lsartory/LitterRobot/PCB/LitterRobot.pdf

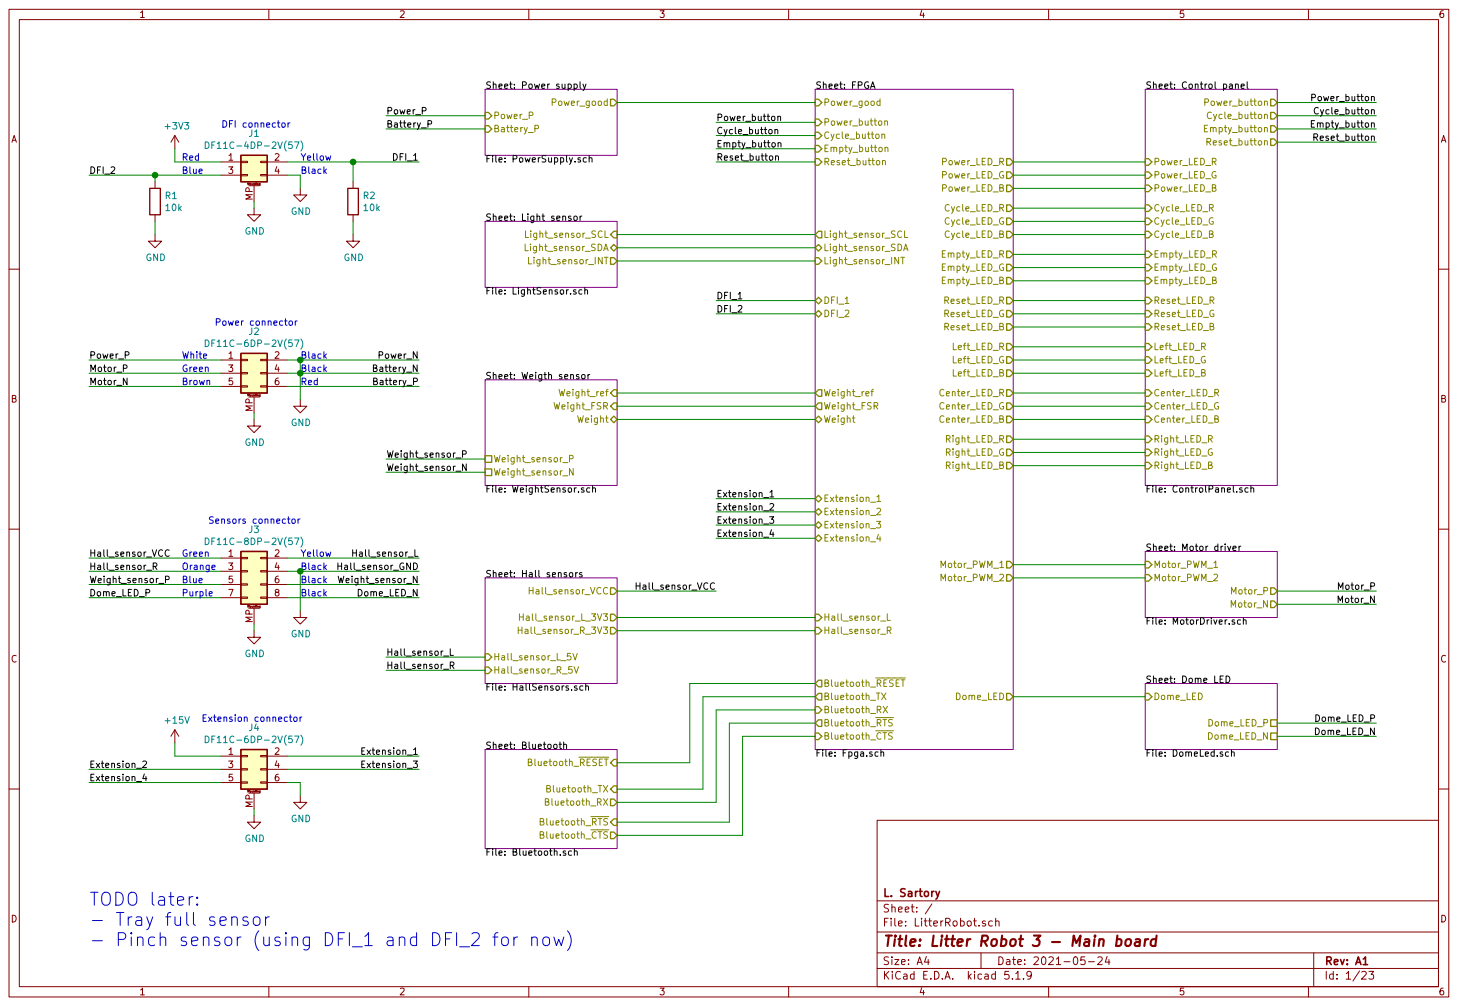
[picture p1: page 1]

Sheet: Control panel File: ControlPanel.sch Power_button Cycle_button

Sheet: Hall sensors File: HallSensors.sch Hall_sensor_VCC

Bluetooth_RESET Sheet: Bluetooth File: Bluetooth.schBluetooth_TX

- Pinch sensor (using DFI_1 and DFI_2 for now) Extension connector

File: LitterRobot.sch Sheet: / L. Sartory

Id: 1/23 Title: Litter Robot 3 - Main board

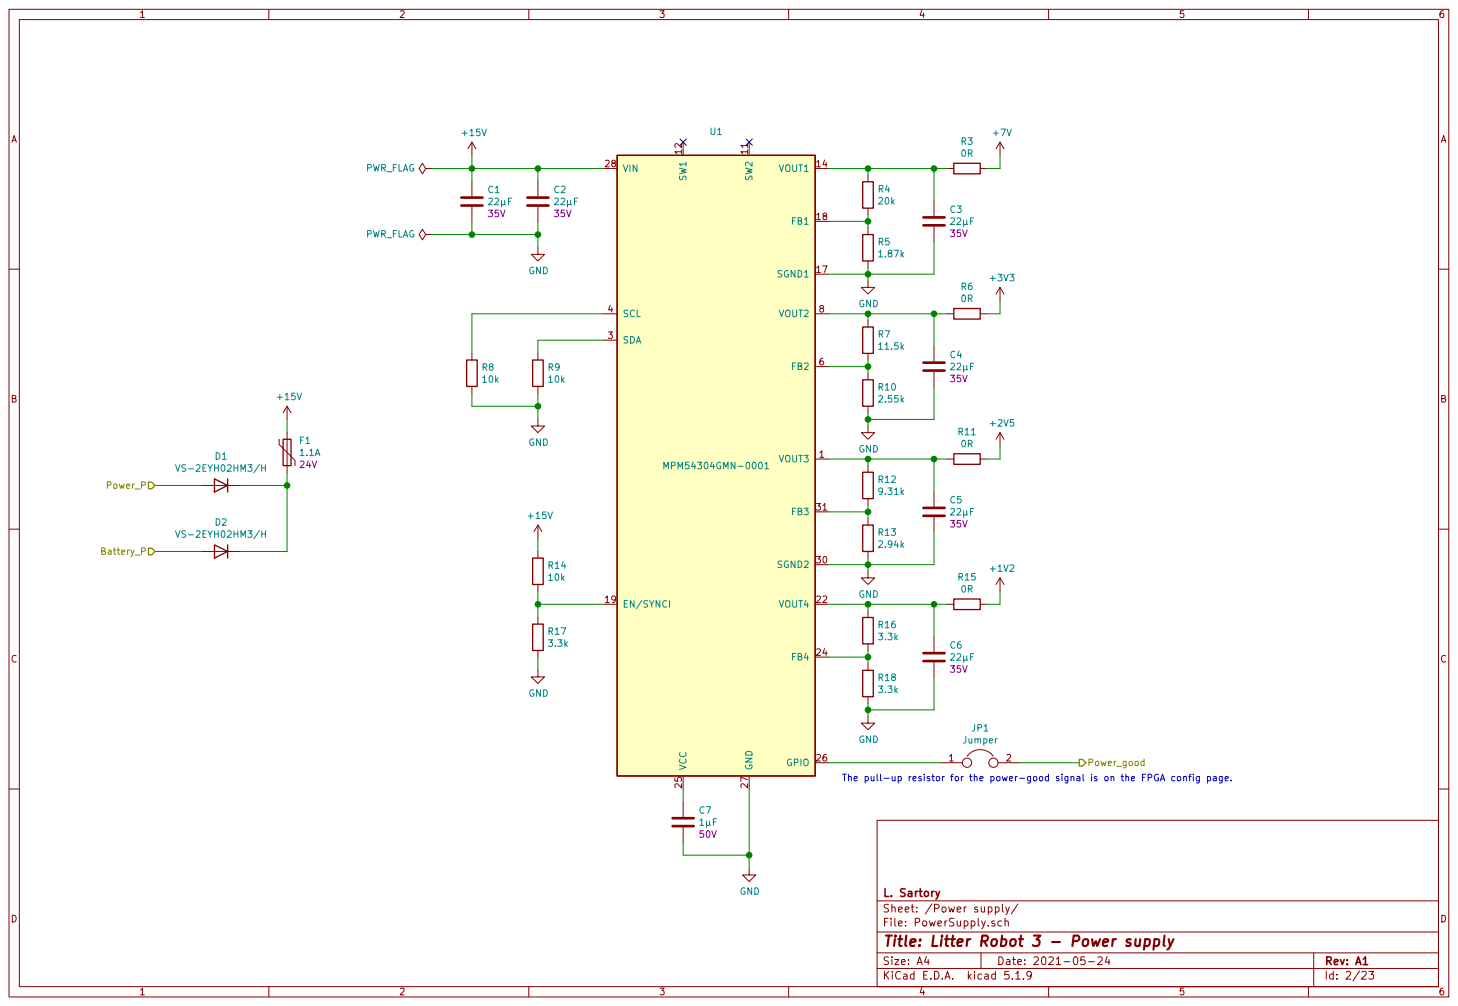
[picture p2: page 2]

The pull-up resistor for the power-good signal is on the FPGA config page.

Sheet: /Power supply/
File: PowerSupply.sch
Id: 2/23 Title: Litter Robot 3 - Power supply

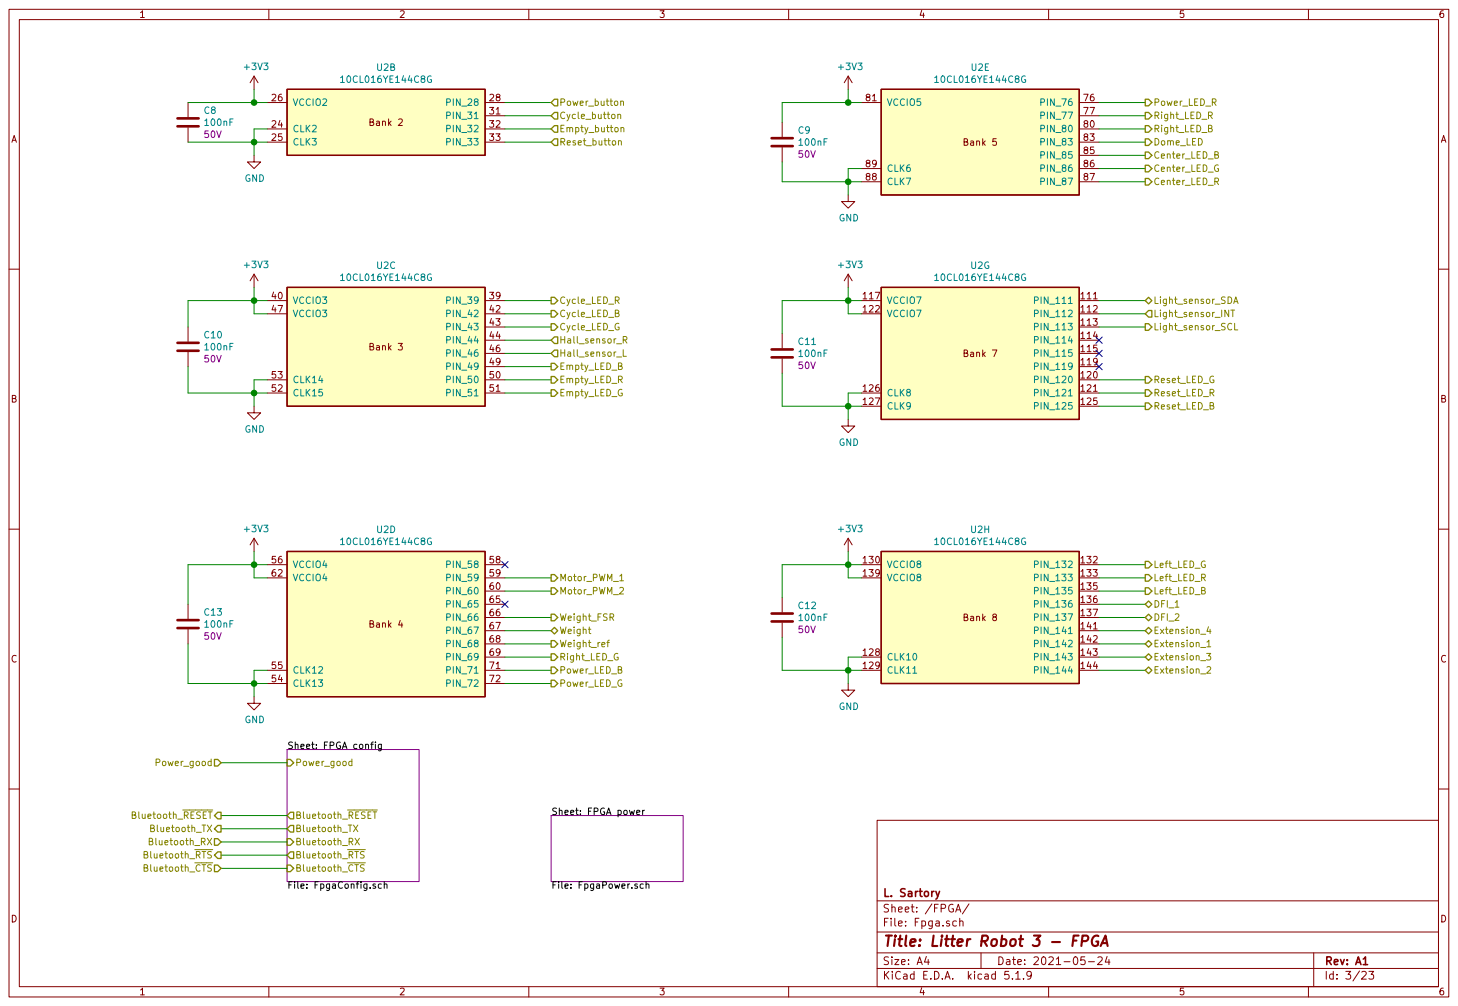
[picture p3: page 3]

File: Fpga.sch Sheet: /FPGA/ L. Sartory

Id: 3/23 Title: Litter Robot 3 - FPGA

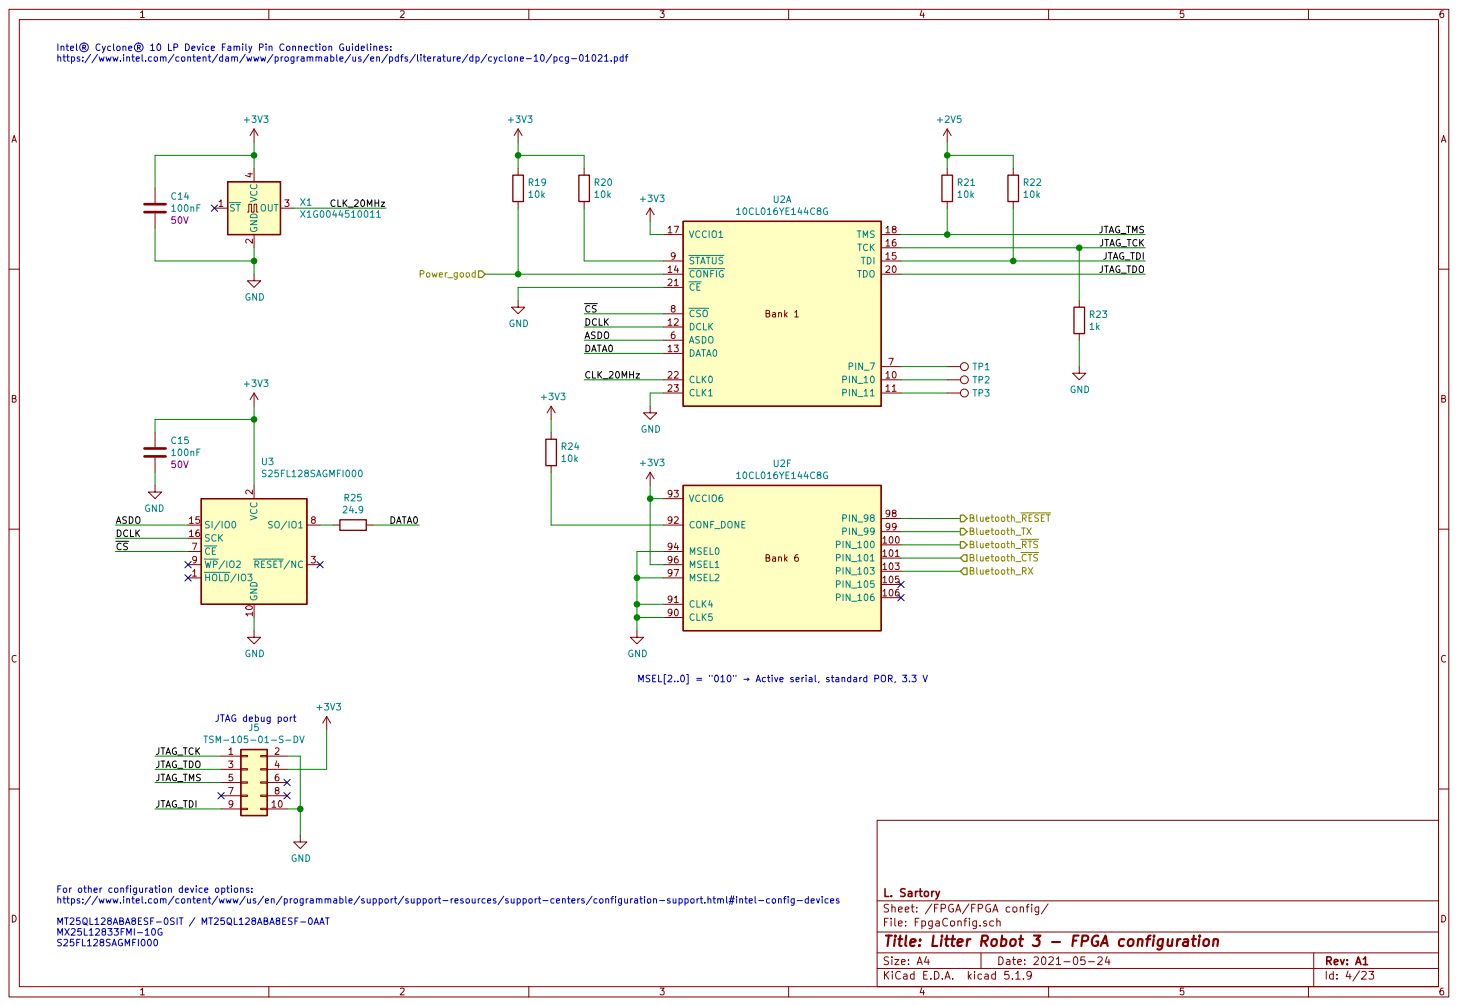
[picture p4: page 4]

Intel® Cyclone® 10 LP Device Family Pin Connection Guidelines:
https://www.intel.com/content/dam/www/programmable/us/en/pdfs/literature/dp/cyclone-10/pcg-01021.pdf

JTAG_TDI MSEL[2..0] = "010" Active serial, standard POR, 3.3 V

2 RESET/NC 3 CE 7 SO/IO1 8 WP/IO2 9 U3S25FL128SAGMFI000 GND

For other configuration device options:
https://www.intel.com/content/www/us/en/programmable/support/support-resources/support-centers/configuration-support.html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 MT25QL128ABA8ESF-0SIT / MT25QL128ABA8ESF-0AAT MX25L12833FMI-10G

L. Sartory
Sheet: /FPGA/FPGA config/
File: FpgaConfig.sch
Id: 4/23 Title: Litter Robot 3 - FPGA configuration

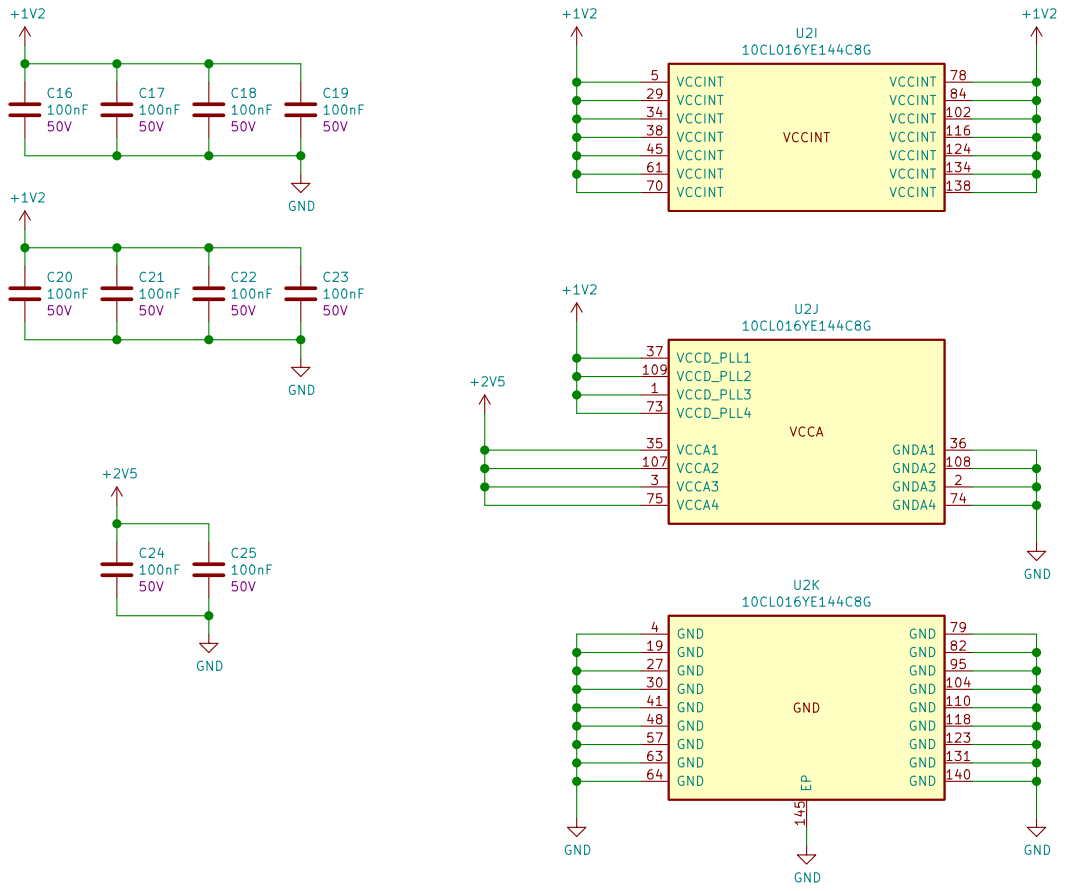
[picture p5: page 5]

L. Sartory
Sheet: /FPGA/FPGA power/
File: FpgaPower.sch
Id: 5/23 Title: Litter Robot 3 - FPGA power supply

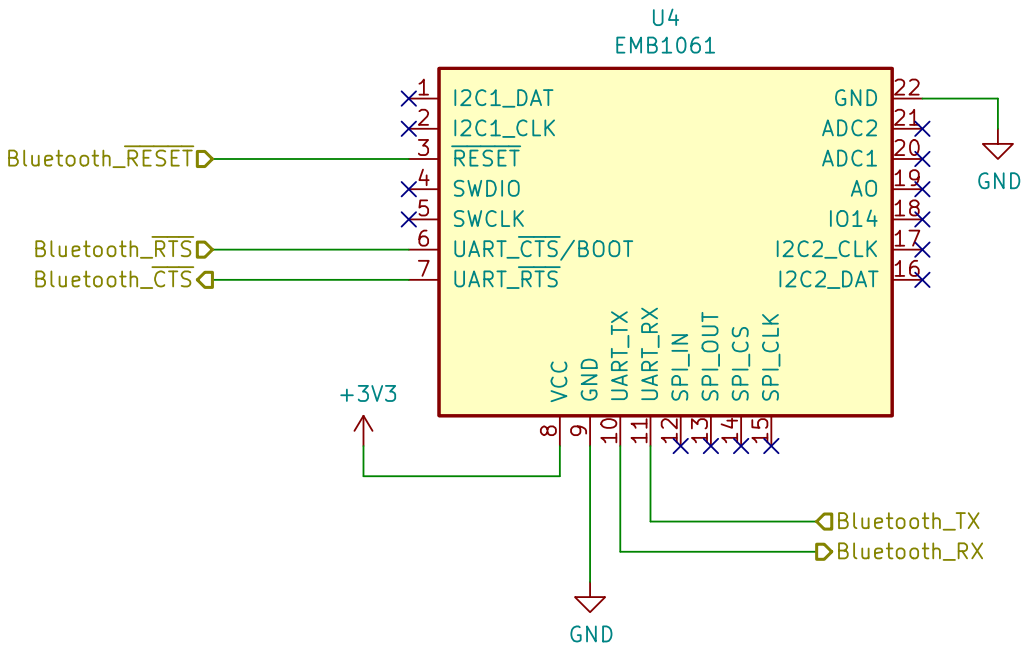
[picture p6: page 6]

File: Bluetooth.sch Sheet: /Bluetooth/ L. Sartory

Id: 6/23 Title: Litter Robot 3 - Bluetooth module

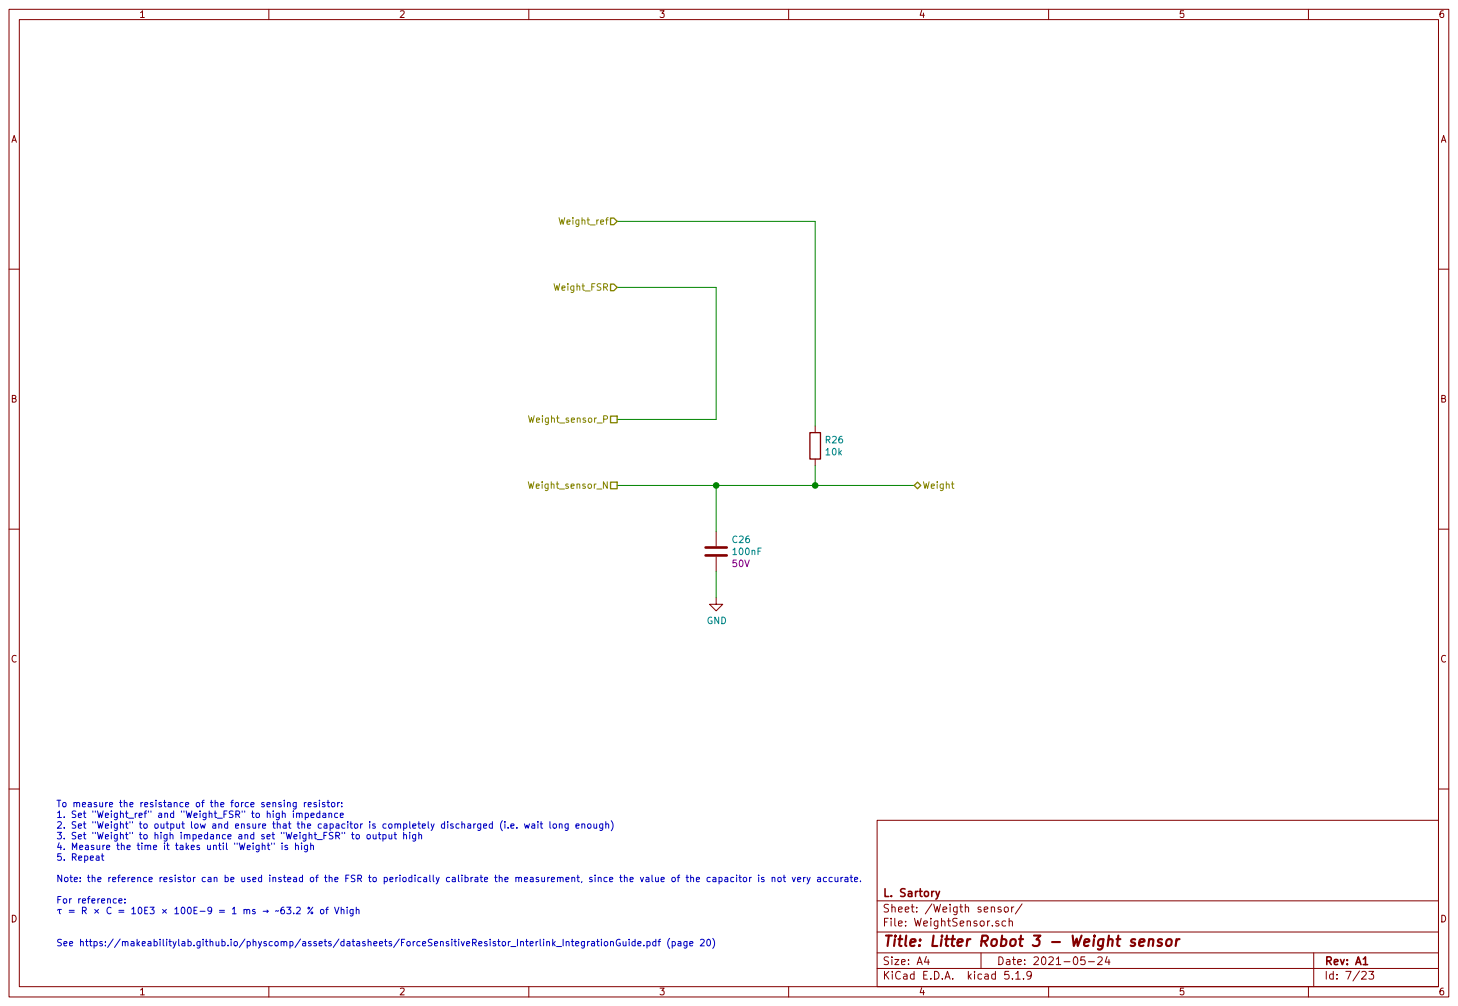
[picture p7: page 7]

To measure the resistance of the force sensing resistor:
1. Set "Weight_ref" and "Weight_FSR" to high impedance
2. Set "Weight" to output low and ensure that the capacitor is completely discharged (i.e. wait long enough)
3. Set "Weight" to high impedance and set "Weight_FSR" to output high
4. Measure the time it takes until "Weight" is high
5. Repeat

Note: the reference resistor can be used instead of the FSR to periodically calibrate the measurement, since the value of the capacitor is not very accurate. For reference:

Sheet: /Weigth sensor/
File: WeightSensor.sch
Id: 7/23 Title: Litter Robot 3 - Weight sensor

See https://makeabilitylab.github.io/physcomp/assets/datasheets/ForceSensitiveResistor_Interlink_IntegrationGuide.pdf (page 20)

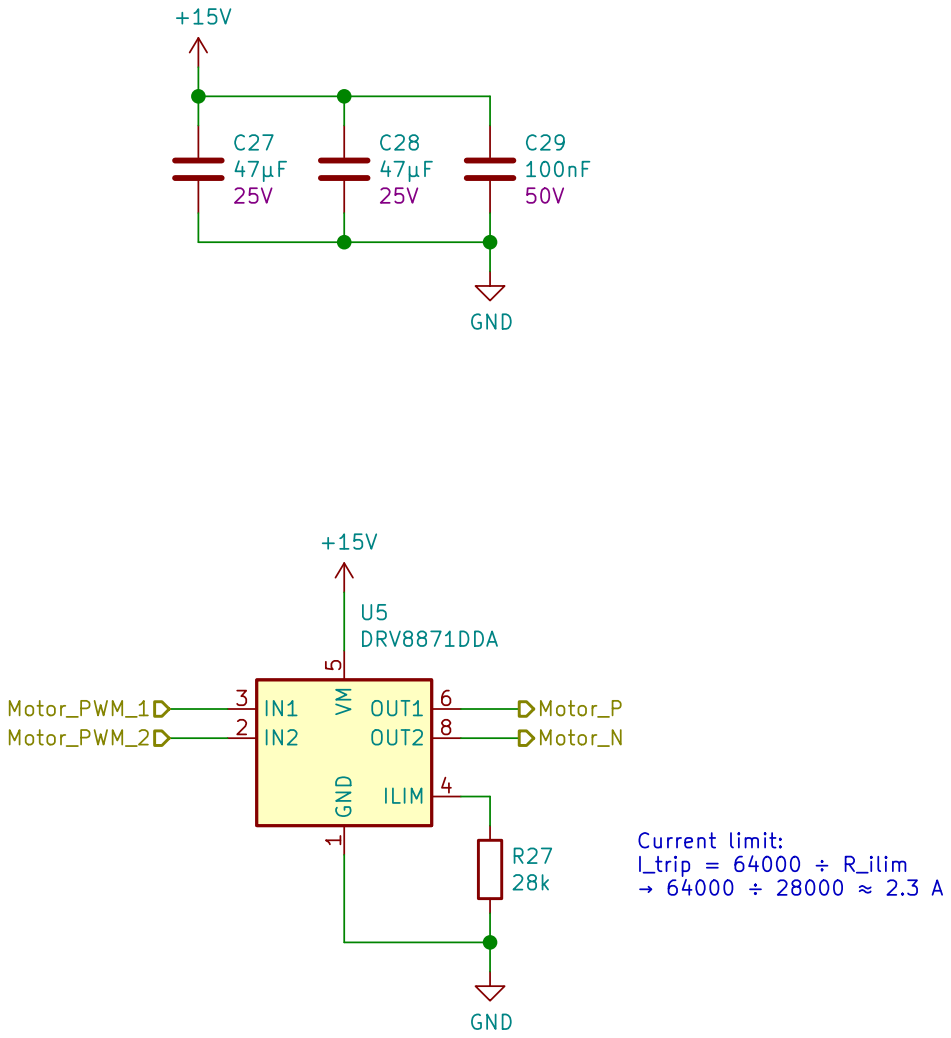
[picture p8: page 8]

Id: 8/23 Title: Litter Robot 3 - Motor driver File: MotorDriver.sch Sheet: /Motor driver/ L. Sartory

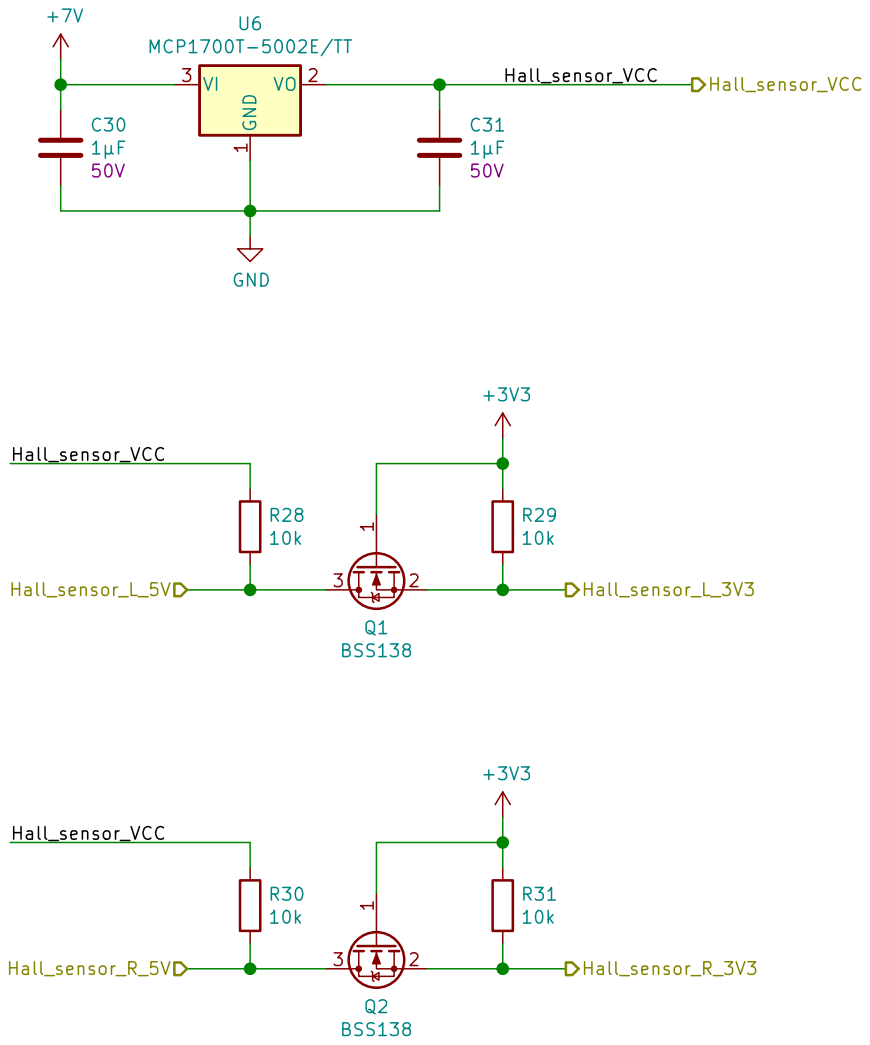
[picture p9: page 9]

File: HallSensors.sch Sheet: /Hall sensors/ L. Sartory

Id: 9/23 Title: Litter Robot 3 - Hall sensors level shifters

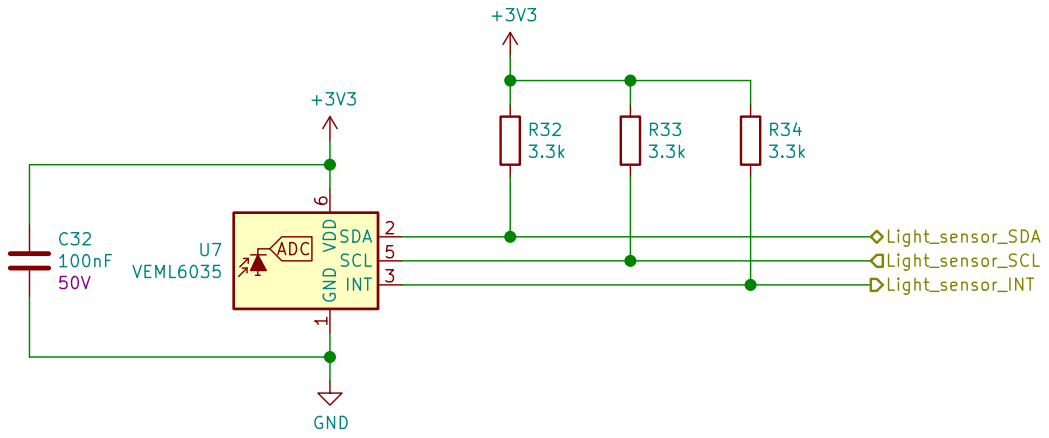
[picture p10: page 10]

Sheet: /Light sensor/
File: LightSensor.sch
Id: 10/23 Title: Litter Robot 3 - Ambient light sensor

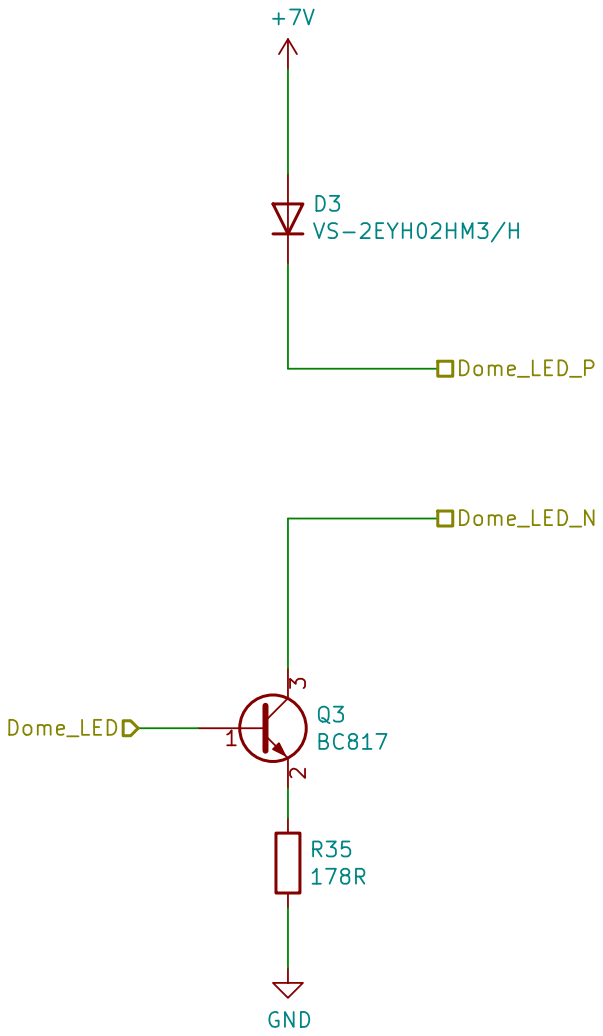
[picture p11: page 11]

Id: 11/23 Title: Litter Robot 3 - Dome LED control File: DomeLed.sch Sheet: /Dome LED/ L. Sartory GND

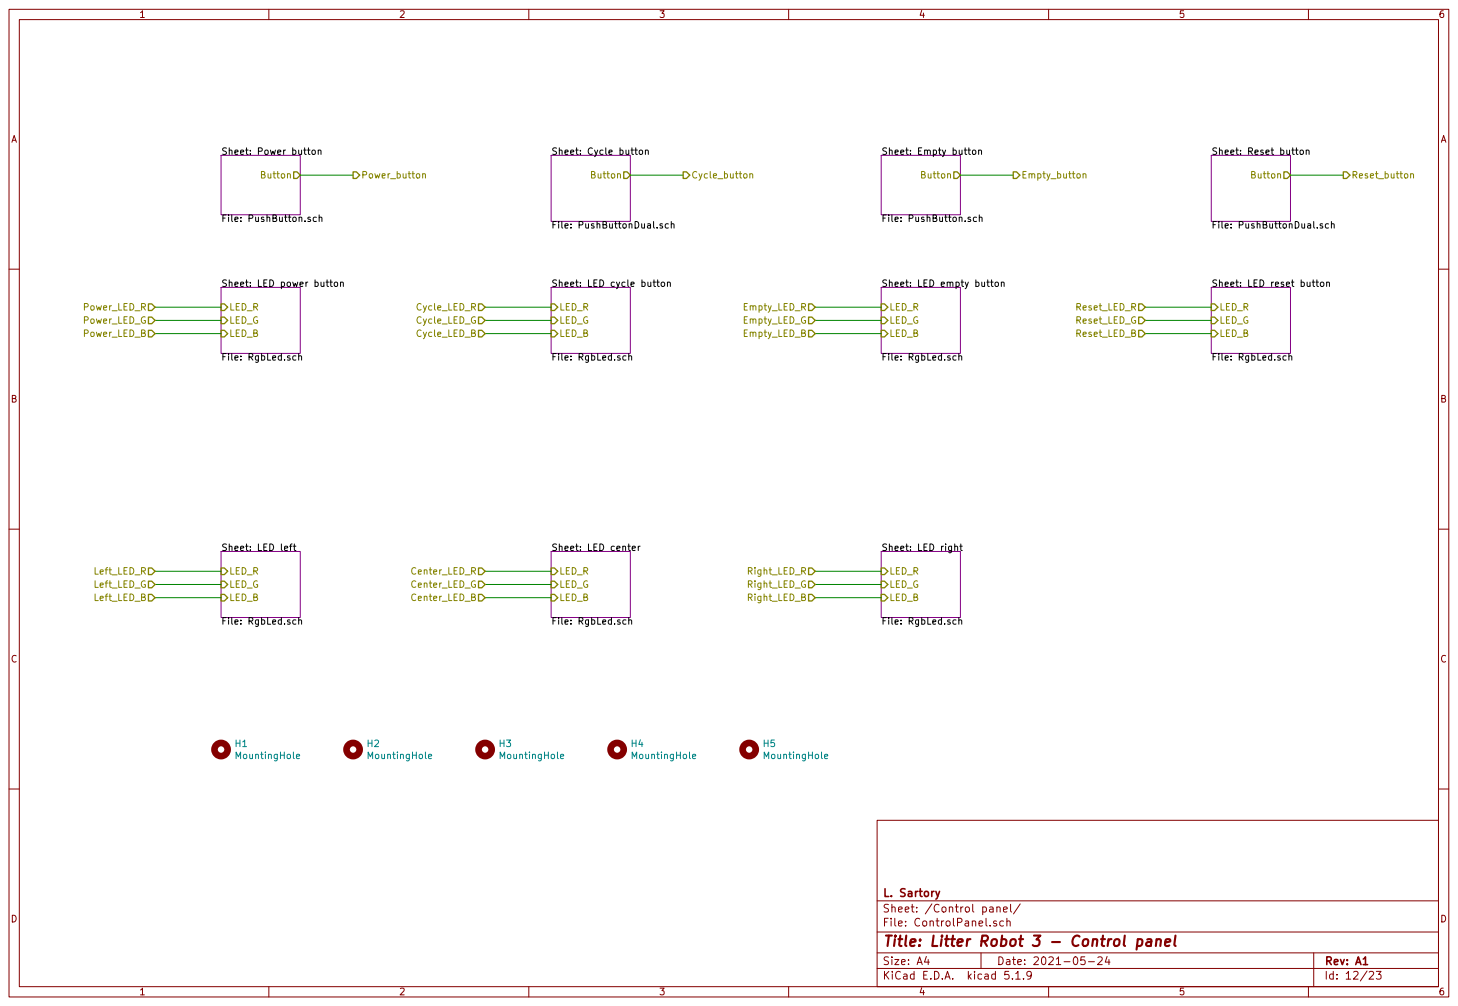
[picture p12: page 12]

Sheet: Reset button File: PushButtonDual.sch Button Sheet: Empty button File: PushButton.sch Button Sheet: LED empty button

Sheet: LED power button

Sheet: LED cycle button

Sheet: LED reset button File: RgbLed.sch

Sheet: LED left File: RgbLed.sch

Sheet: LED center File: RgbLed.sch

L. Sartory
Id: 12/23 Title: Litter Robot 3 - Control panel File: ControlPanel.sch Sheet: /Control panel/

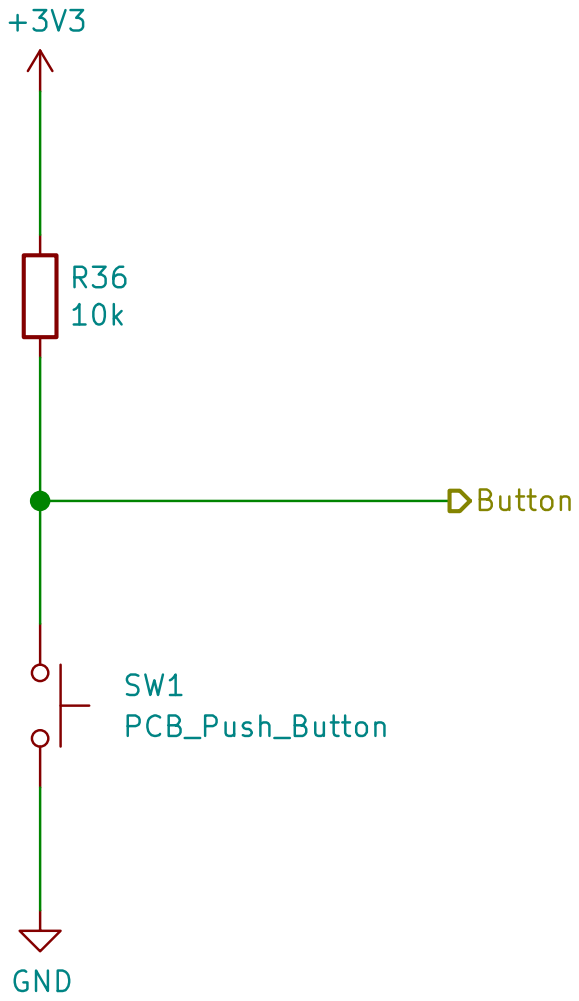
[picture p13: page 13]

L. Sartory
Id: 13/23 Title: Litter Robot 3 - Push button (single) File: PushButton.sch Sheet: /Control panel/Power button/

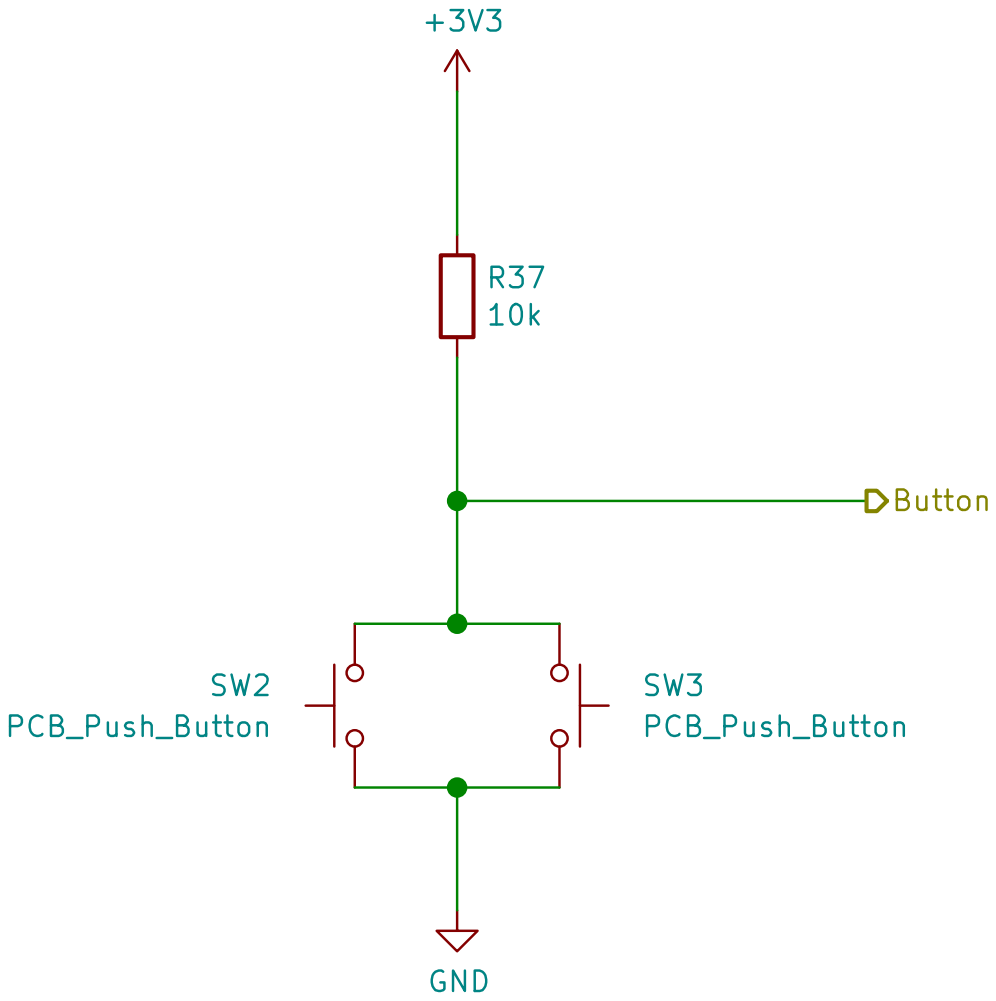
[picture p14: page 14]

L. Sartory
Id: 14/23 Title: Litter Robot 3 - Push button (dual) File: PushButtonDual.sch Sheet: /Control panel/Cycle button/

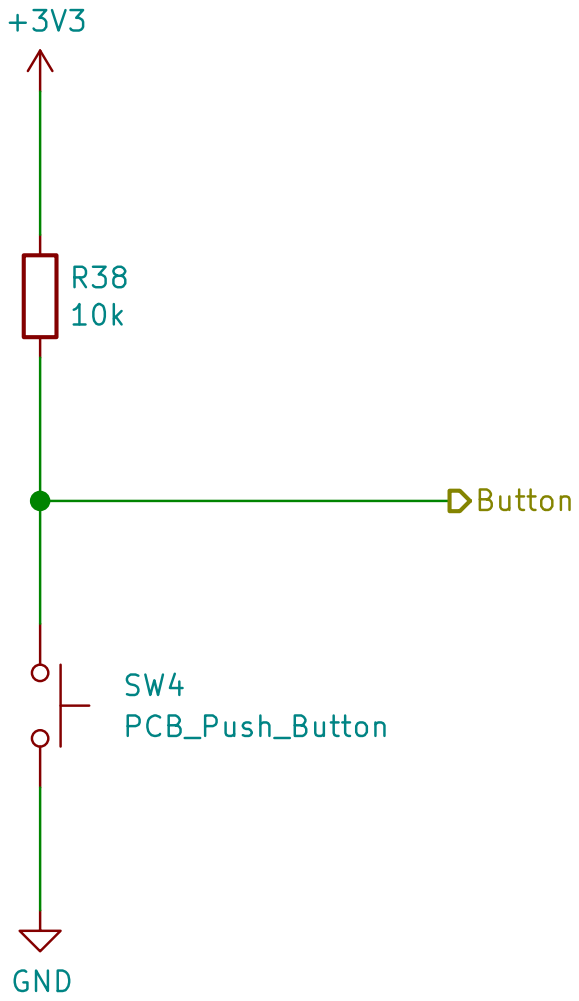
[picture p15: page 15]

L. Sartory
Id: 15/23 Title: Litter Robot 3 - Push button (single) File: PushButton.sch Sheet: /Control panel/Empty button/

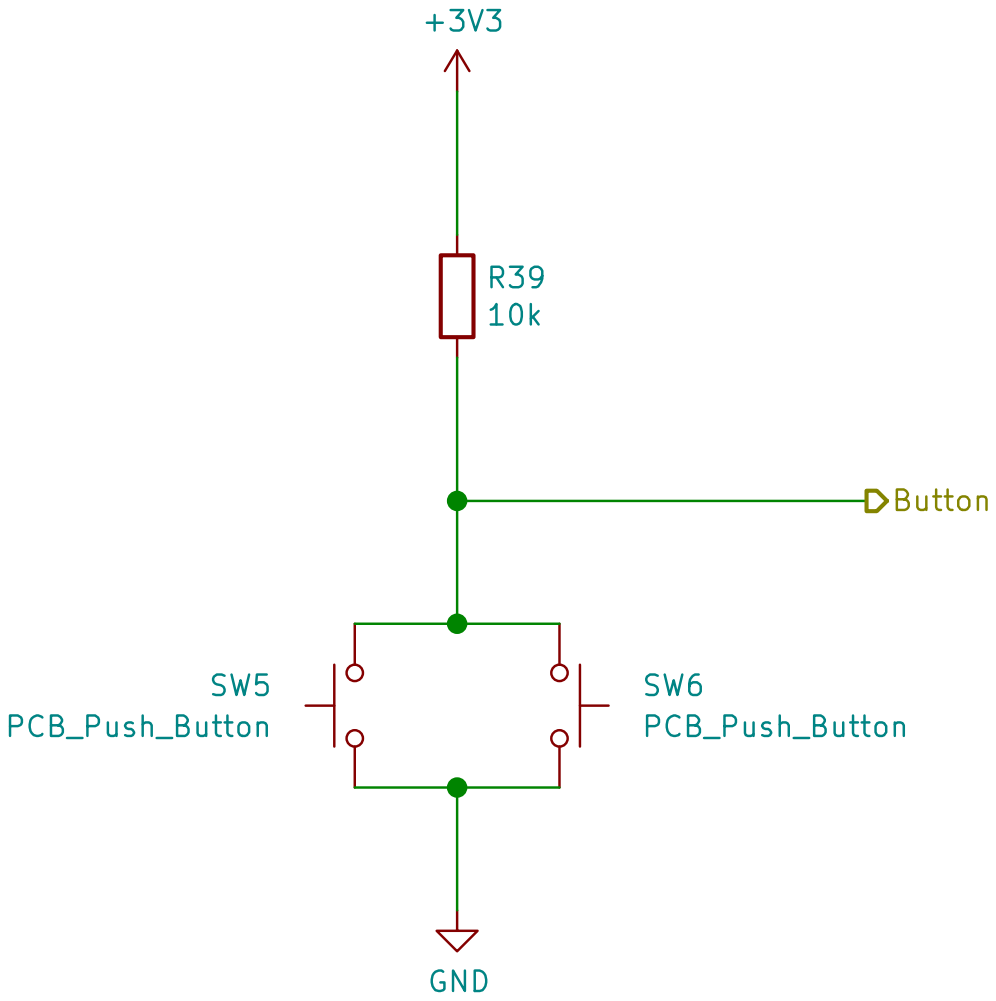
[picture p16: page 16]

L. Sartory
Id: 16/23 Title: Litter Robot 3 - Push button (dual) File: PushButtonDual.sch Sheet: /Control panel/Reset button/

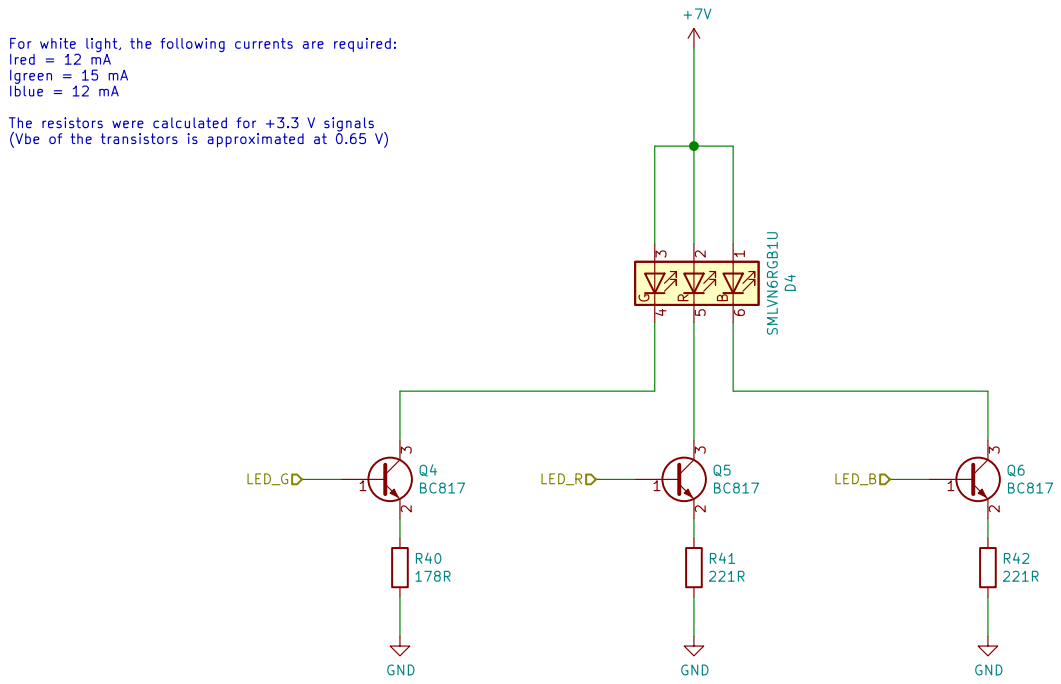
[picture p17: page 17]

For white light, the following currents are required:
Ired = 12 mA
Igreen = 15 mA
Iblue = 12 mA

The resistors were calculated for +3.3 V signals
(Vbe of the transistors is approximated at 0.65 V)

Sheet: /Control panel/LED power button/
File: RgbLed.sch
Id: 17/23 Title: Litter Robot 3 - RGB LED

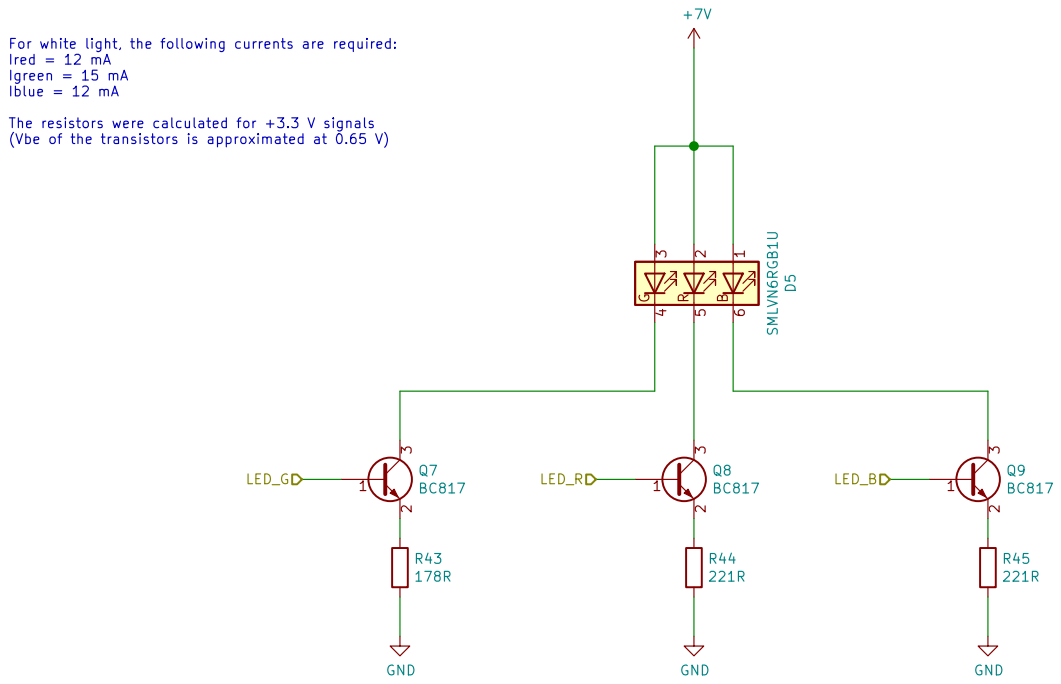
[picture p18: page 18]
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

Sheet: /Control panel/LED cycle button/
File: RgbLed.sch
Id: 18/23 Title: Litter Robot 3 - RGB LED

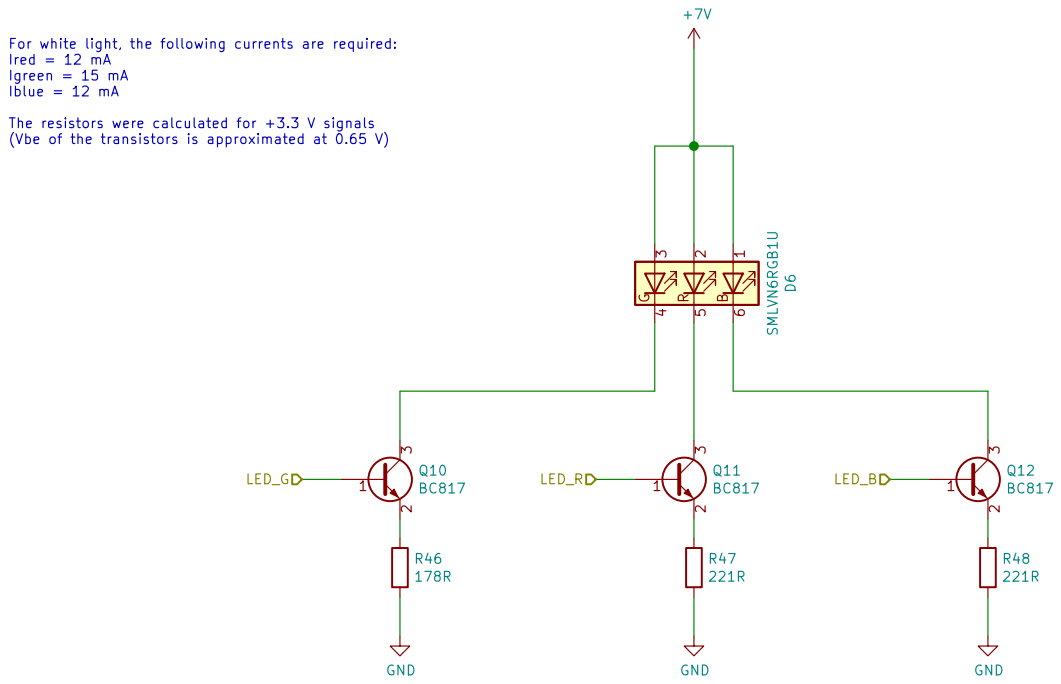
[picture p19: page 19]
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

Sheet: /Control panel/LED empty button/
File: RgbLed.sch
Id: 19/23 Title: Litter Robot 3 - RGB LED

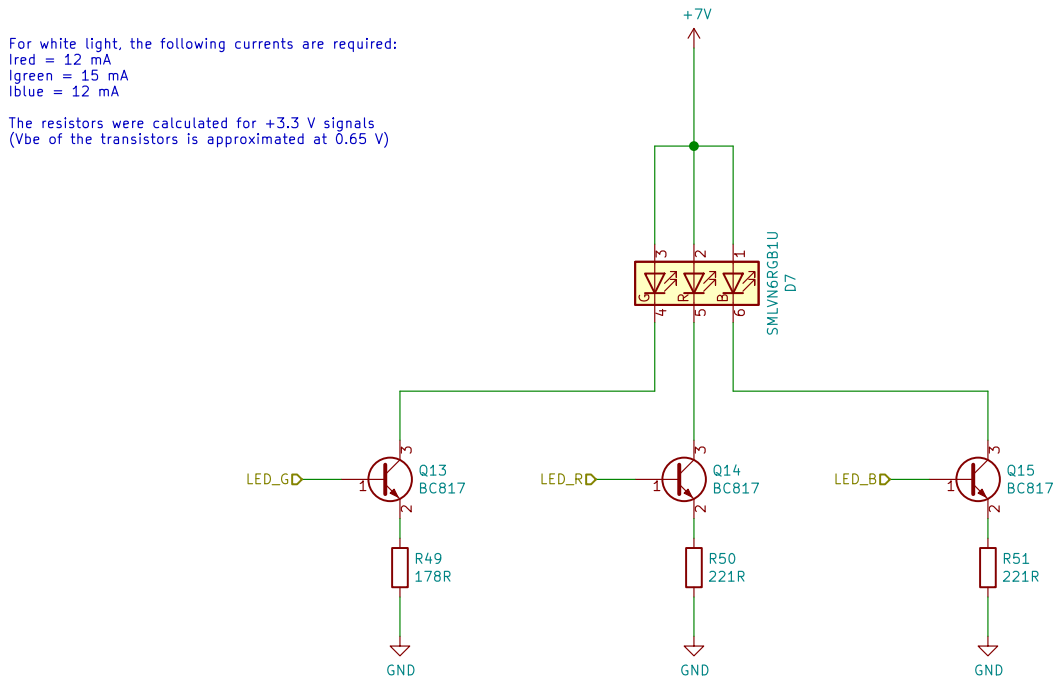
[picture p20: page 20]
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

Sheet: /Control panel/LED reset button/
File: RgbLed.sch
Id: 20/23 Title: Litter Robot 3 - RGB LED

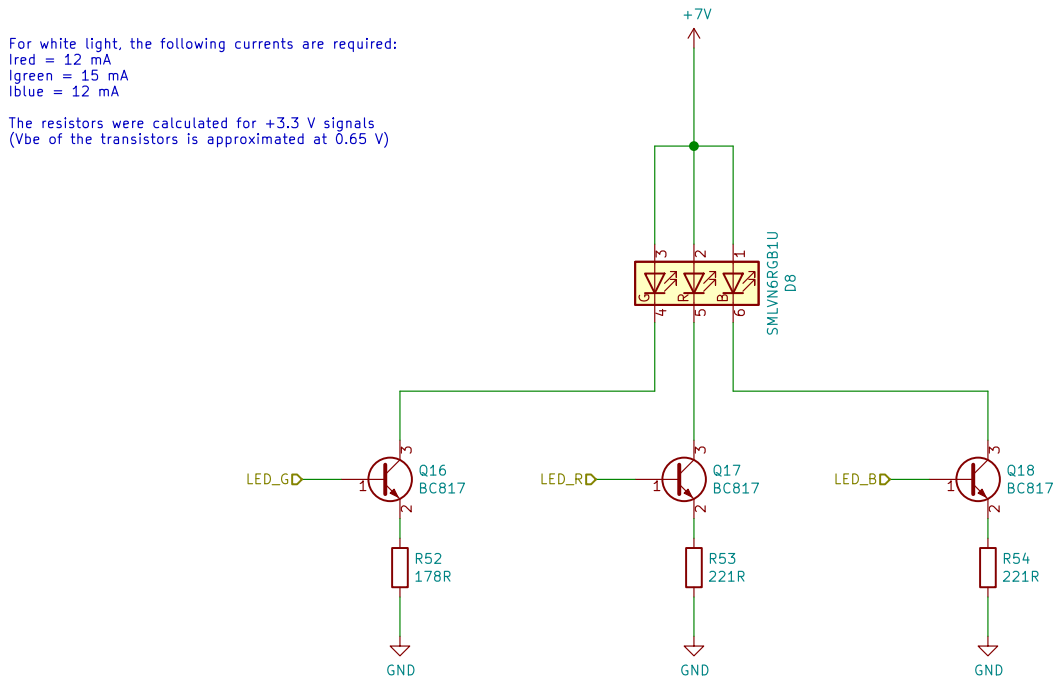
[picture p21: page 21]
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

Sheet: /Control panel/LED left/
File: RgbLed.sch
Id: 21/23 Title: Litter Robot 3 - RGB LED

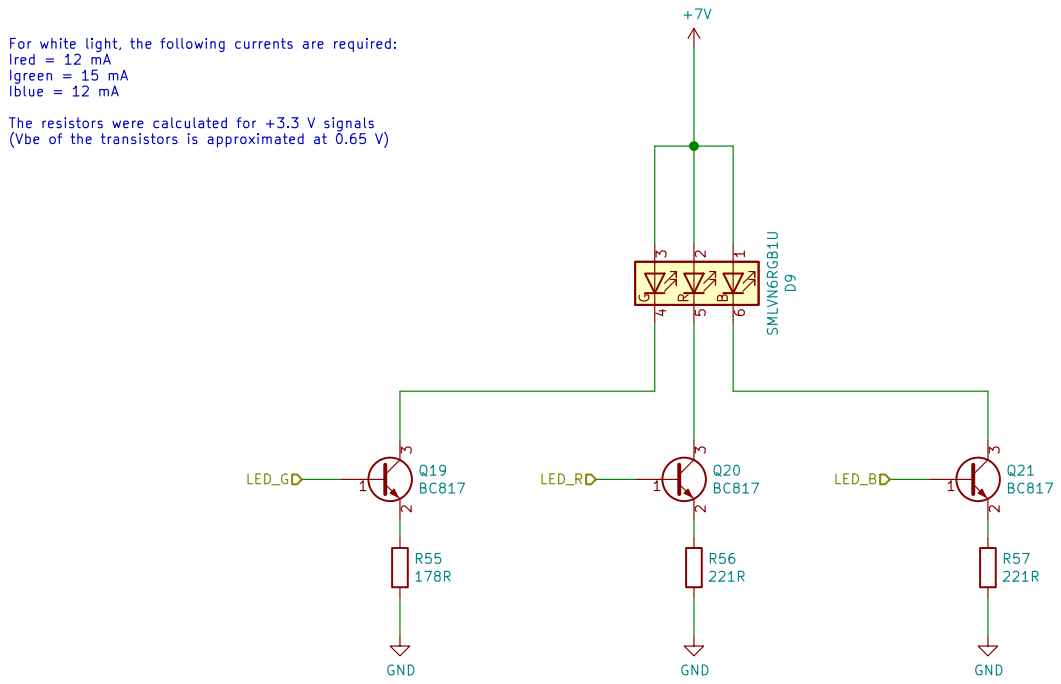
[picture p22: page 22]
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

Sheet: /Control panel/LED center/
File: RgbLed.sch
Id: 22/23 Title: Litter Robot 3 - RGB LED

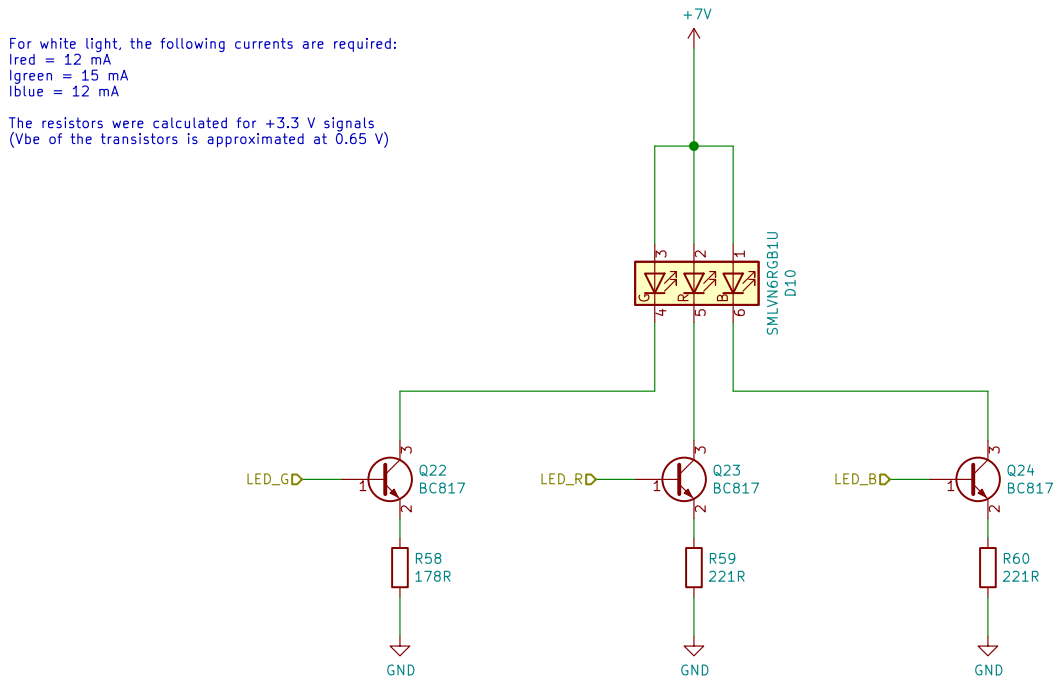
[picture p23: page 23]
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

Sheet: /Control panel/LED right/
File: RgbLed.sch
Id: 23/23 Title: Litter Robot 3 - RGB LED
