lsartory/LitterRobot/PCB/LitterRobot.kicad_pcb

## KiCad design PCB/LitterRobot.kicad_pcb (2021-06-23)

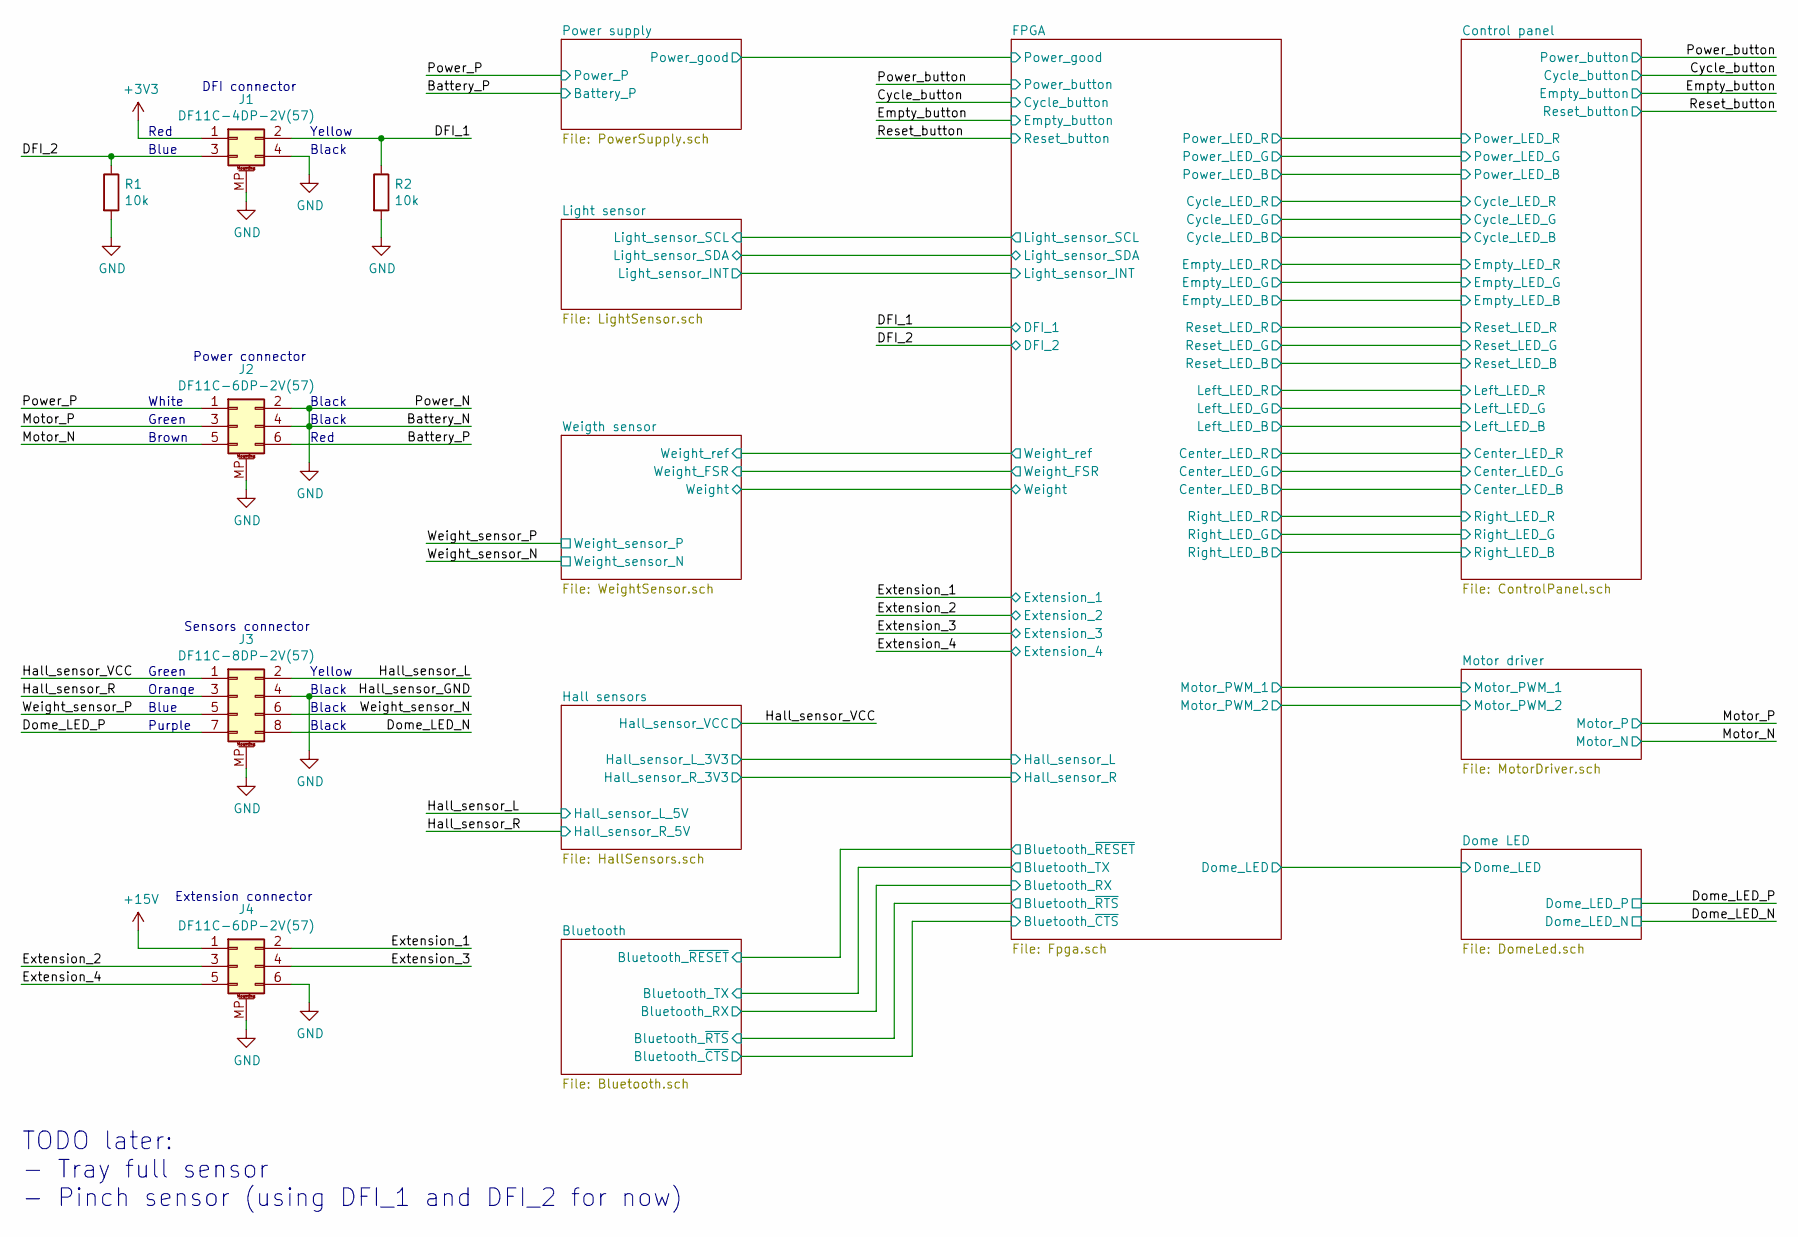
[picture p24: schematic LitterRobot.sch, Litter Robot 3 - Main board]

Parts:
J1: DF11C-4DP-2V(57); Hirose_DF11C-4DP-2V(57); Part_number DF11C-4DP-2V(57)
J2, J4: DF11C-6DP-2V(57); Hirose_DF11C-6DP-2V(57); Part_number DF11C-6DP-2V(57)
J3: DF11C-8DP-2V(57); Hirose_DF11C-8DP-2V(57); Part_number DF11C-8DP-2V(57)
R1, R2: 10k; R_0603_1608Metric; Part_number CR0603-FX-1002ELF

Connections:
+3V3: J1.1; also elsewhere on the board
+15V: J4.1; also elsewhere on the board
/Battery_P: J2.6; also elsewhere on the board
/DFI_1: J1.2, R2.1; also elsewhere on the board
/DFI_2: J1.3, R1.1; also elsewhere on the board
/Dome_LED_N: J3.8; also elsewhere on the board
/Dome_LED_P: J3.7; also elsewhere on the board
/Extension_1: J4.2; also elsewhere on the board
/Extension_2: J4.3; also elsewhere on the board
/Extension_3: J4.4; also elsewhere on the board
/Extension_4: J4.5; also elsewhere on the board
/Hall_sensor_L: J3.2; also elsewhere on the board
/Hall_sensor_R: J3.3; also elsewhere on the board
/Hall_sensor_VCC: J3.1; also elsewhere on the board
/Motor_N: J2.5; also elsewhere on the board
/Motor_P: J2.3; also elsewhere on the board
/Power_P: J2.1; also elsewhere on the board
/Weight_sensor_N: J3.6; also elsewhere on the board
/Weight_sensor_P: J3.5; also elsewhere on the board
GND: J1.4, J1.MP (MountPin), J2.2, J2.4, J2.MP (MountPin), J3.4, J3.MP (MountPin), J4.6, J4.MP (MountPin), R1.2, R2.2; also elsewhere on the board

Notes on the sheet:
Red
Blue
Yellow
Black
DFI connector
Power connector
White
Green
Brown
Sensors connector
Orange
Purple
Extension connector
TODO later: - Tray full sensor - Pinch sensor (using DFI_1 and DFI_2 for now)

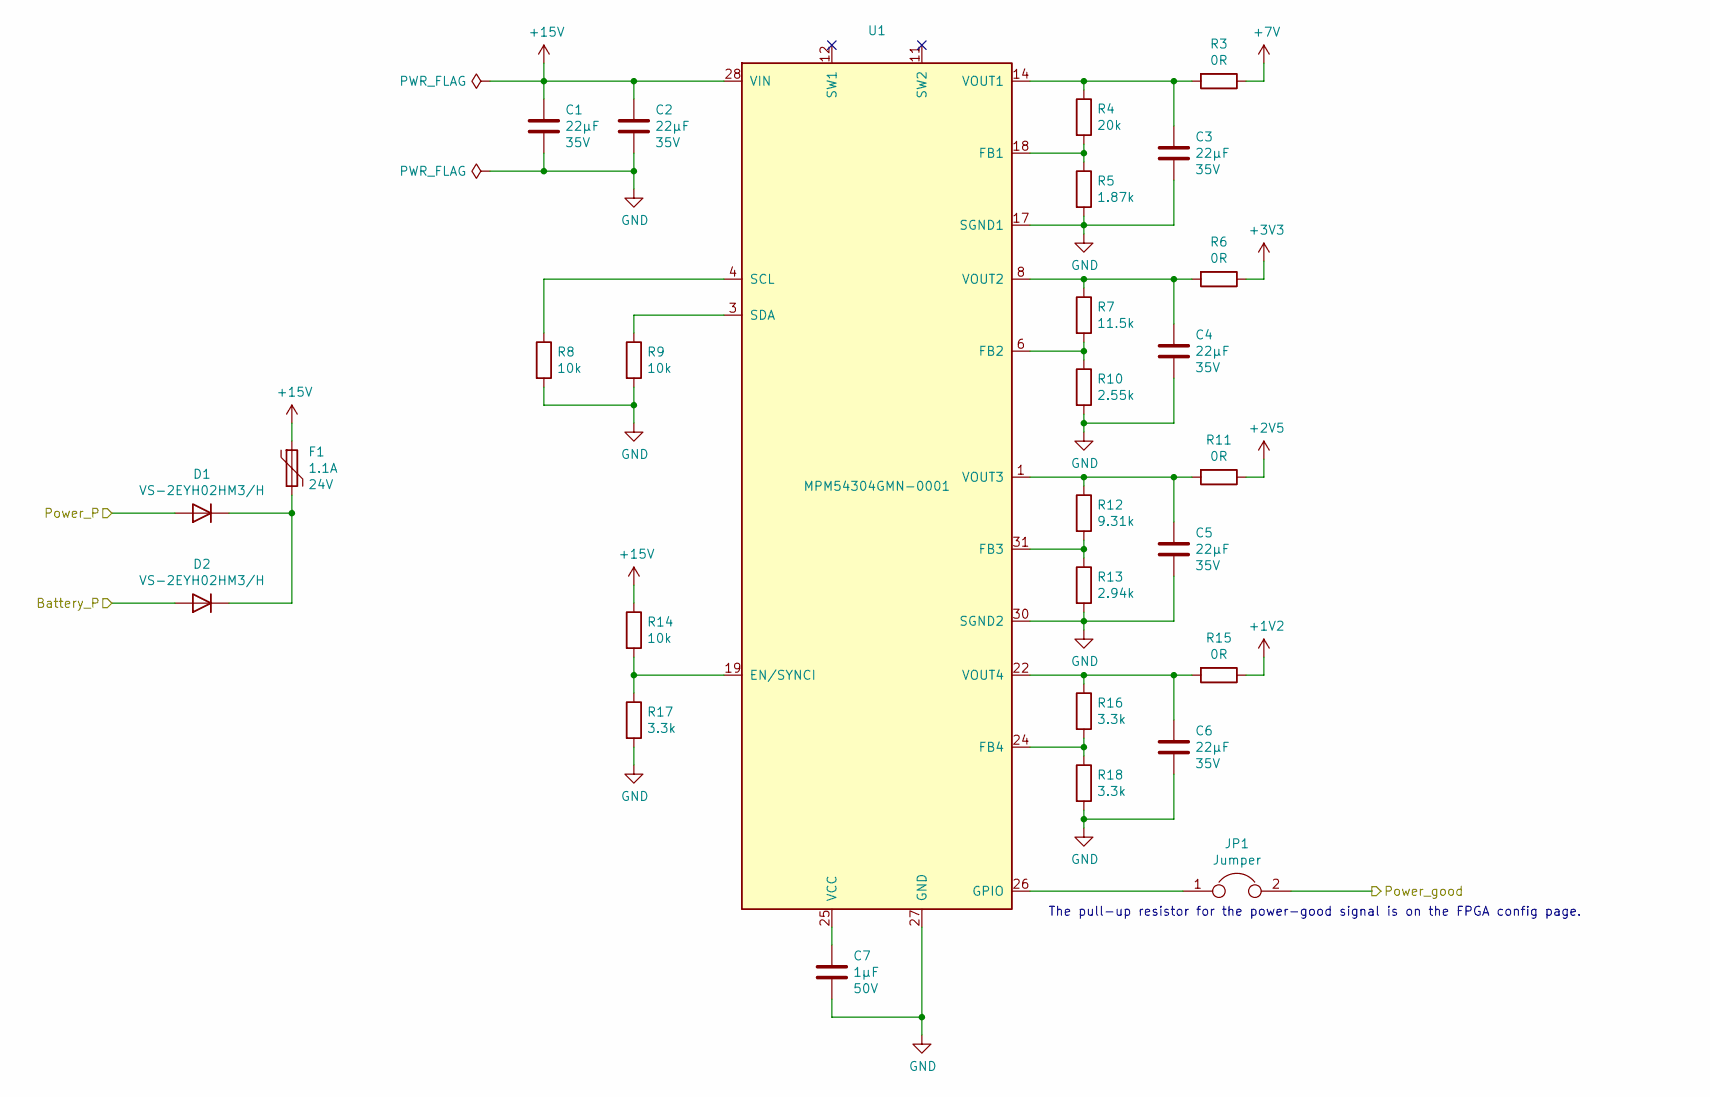
[picture p25: schematic PowerSupply.sch, Litter Robot 3 - Power supply]

Parts:
C1, C2, C3, C4, C5, C6: 22µF; C_1206_3216Metric; Voltage 35V; Part_number C3216X5R1V226M160AC
C7: 1µF; C_0603_1608Metric; Voltage 50V; Part_number C1608X5R1H105K080AB
D1, D2: VS-2EYH02HM3/H; Vishay_SlimSMAW; Part_number VS-2EYH02HM3/H
F1: 1.1A; Bel_Fuse_0ZCG; Voltage 24V; Part_number 0ZCG0110BF2B
JP1: Jumper; SolderJumper-2_P1.3mm_Bridged_RoundedPad1.0x1.5mm
R3, R6, R11, R15: 0R; R_0603_1608Metric; Part_number CR0603-J/-000ELF
R4: 20k; R_0603_1608Metric; Part_number CR0603-FX-2002ELF
R5: 1.87k; R_0603_1608Metric; Part_number CR0603-FX-1871ELF
R7: 11.5k; R_0603_1608Metric; Part_number CR0603-FX-1152ELF
R8, R9, R14: 10k; R_0603_1608Metric; Part_number CR0603-FX-1002ELF
R10: 2.55k; R_0603_1608Metric; Part_number CR0603-FX-2551ELF
R12: 9.31k; R_0603_1608Metric; Part_number CR0603-FX-9311ELF
R13: 2.94k; R_0603_1608Metric; Part_number CR0603-FX-2941ELF
R16, R17, R18: 3.3k; R_0603_1608Metric; Part_number CR0603-FX-3301ELF
U1: MPM54304GMN-0001; MPS_MPM54304_LGA33_7x7mm; Part_number MPM54304GMN-0001

Connections:
+1V2: R15.1; also elsewhere on the board
+2V5: R11.1; also elsewhere on the board
+3V3: R6.1; also elsewhere on the board
+7V: R3.1; also elsewhere on the board
+15V: C1.1, C2.1, F1.1, R14.1, U1.28 (VIN), U1.29 (VIN); also elsewhere on the board
/Battery_P: D2.2 (A); also elsewhere on the board
/FPGA/Power_good: JP1.2; also elsewhere on the board
/Power_P: D1.2 (A); also elsewhere on the board
GND: C1.2, C2.2, C3.2, C4.2, C5.2, C6.2, C7.2, R5.2, R8.2, R9.2, R10.2, R13.2, R17.2, R18.2, U1.2 (GND), U1.5 (GND), U1.7 (GND), U1.10 (GND), U1.13 (GND), U1.16 (GND), U1.17 (SGND1), U1.20 (GND), U1.21 (GND), U1.27 (GND), U1.30 (SGND2), U1.33 (GND); also elsewhere on the board
unnamed: C3.1, R3.2, R4.1, U1.14 (VOUT1), U1.15 (VOUT1)
unnamed: C4.1, R6.2, R7.1, U1.8 (VOUT2), U1.9 (VOUT2)
unnamed: C5.1, R11.2, R12.1, U1.1 (VOUT3), U1.32 (VOUT3)
unnamed: C6.1, R15.2, R16.1, U1.22 (VOUT4), U1.23 (VOUT4)
unnamed: C7.1, U1.25 (VCC)
unnamed: D1.1 (K), D2.1 (K), F1.2
unnamed: JP1.1, U1.26 (GPIO)
unnamed: R4.2, R5.1, U1.18 (FB1)
unnamed: R8.1, U1.4 (SCL)
unnamed: R9.1, U1.3 (SDA)
unnamed: R7.2, R10.1, U1.6 (FB2)
unnamed: R12.2, R13.1, U1.31 (FB3)
unnamed: R14.2, R17.1, U1.19 (EN/SYNCI)
unnamed: R16.2, R18.1, U1.24 (FB4)

Notes on the sheet:
The pull-up resistor for the power-good signal is on the FPGA config page.

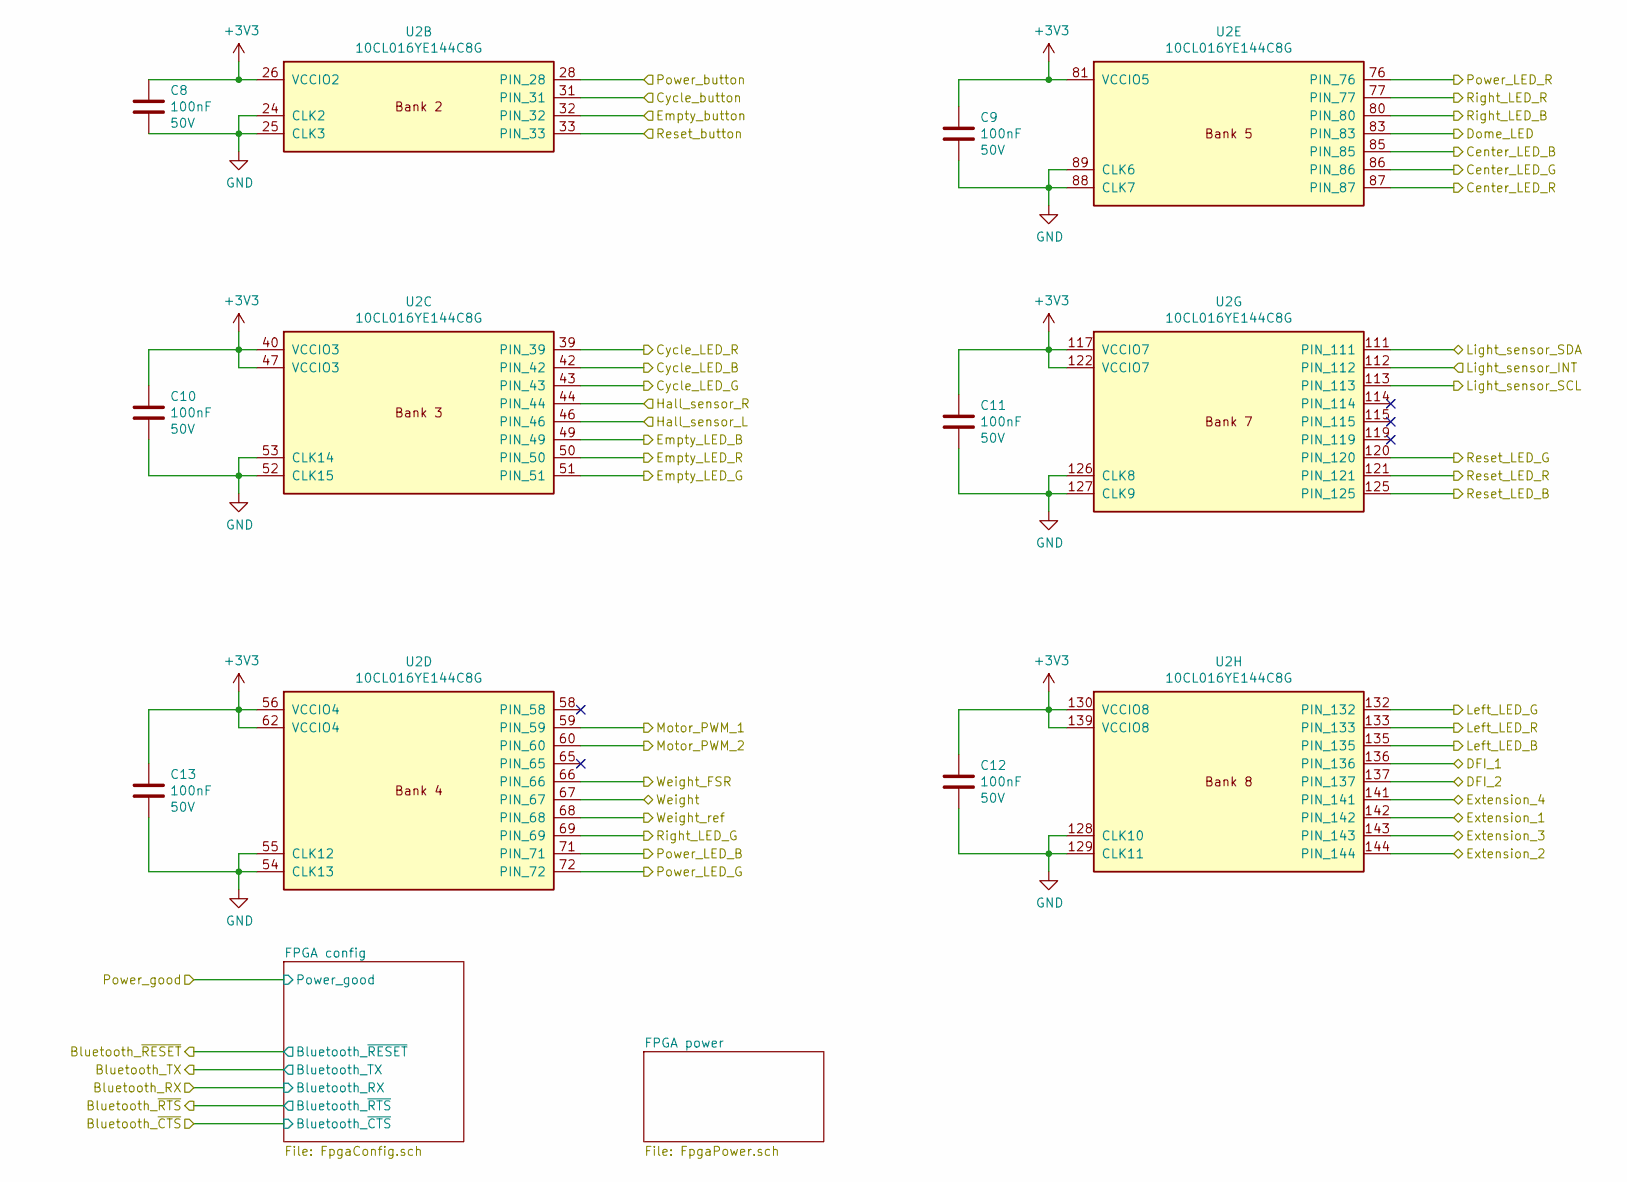
[picture p26: schematic Fpga.sch, Litter Robot 3 - FPGA]

Parts:
C8, C9, C10, C11, C12, C13: 100nF; C_0603_1608Metric; Voltage 50V; Part_number C1608X5R1H104K080AA
U2: 10CL016YE144C8G; Intel_EQFP-144-1EP_20x20mm_P0.5mm_EP6.7x6.7mm; Part_number 10CL016YE144C8G

Connections:
+3V3: C8.1, C9.1, C10.1, C11.1, C12.1, C13.1, U2.26 (VCCIO2), U2.40 (VCCIO3), U2.47 (VCCIO3), U2.56 (VCCIO4), U2.62 (VCCIO4), U2.81 (VCCIO5), U2.117 (VCCIO7), U2.122 (VCCIO7), U2.130 (VCCIO8), U2.139 (VCCIO8); also elsewhere on the board
/Control panel/Center_LED_B: U2.85 (PIN_85); also elsewhere on the board
/Control panel/Center_LED_G: U2.86 (PIN_86); also elsewhere on the board
/Control panel/Center_LED_R: U2.87 (PIN_87); also elsewhere on the board
/Control panel/Cycle_LED_B: U2.42 (PIN_42); also elsewhere on the board
/Control panel/Cycle_LED_G: U2.43 (PIN_43); also elsewhere on the board
/Control panel/Cycle_LED_R: U2.39 (PIN_39); also elsewhere on the board
/Control panel/Empty_LED_B: U2.49 (PIN_49); also elsewhere on the board
/Control panel/Empty_LED_G: U2.51 (PIN_51); also elsewhere on the board
/Control panel/Empty_LED_R: U2.50 (PIN_50); also elsewhere on the board
/Control panel/Left_LED_B: U2.135 (PIN_135); also elsewhere on the board
/Control panel/Left_LED_G: U2.132 (PIN_132); also elsewhere on the board
/Control panel/Left_LED_R: U2.133 (PIN_133); also elsewhere on the board
/Control panel/Power_LED_B: U2.71 (PIN_71); also elsewhere on the board
/Control panel/Power_LED_G: U2.72 (PIN_72); also elsewhere on the board
/Control panel/Power_LED_R: U2.76 (PIN_76); also elsewhere on the board
/Control panel/Reset_LED_B: U2.125 (PIN_125); also elsewhere on the board
/Control panel/Reset_LED_G: U2.120 (PIN_120); also elsewhere on the board
/Control panel/Reset_LED_R: U2.121 (PIN_121); also elsewhere on the board
/Control panel/Right_LED_B: U2.80 (PIN_80); also elsewhere on the board
/Control panel/Right_LED_G: U2.69 (PIN_69); also elsewhere on the board
/Control panel/Right_LED_R: U2.77 (PIN_77); also elsewhere on the board
/Cycle_button: U2.31 (PIN_31); also elsewhere on the board
/DFI_1: U2.136 (PIN_136); also elsewhere on the board
/DFI_2: U2.137 (PIN_137); also elsewhere on the board
/Dome LED/Dome_LED: U2.83 (PIN_83); also elsewhere on the board
/Extension_1: U2.142 (PIN_142); also elsewhere on the board
/Extension_2: U2.144 (PIN_144); also elsewhere on the board
/Extension_3: U2.143 (PIN_143); also elsewhere on the board
/Extension_4: U2.141 (PIN_141); also elsewhere on the board
/FPGA/Hall_sensor_L: U2.46 (PIN_46); also elsewhere on the board
/FPGA/Hall_sensor_R: U2.44 (PIN_44); also elsewhere on the board
/FPGA/Light_sensor_INT: U2.112 (PIN_112); also elsewhere on the board
/FPGA/Light_sensor_SCL: U2.113 (PIN_113); also elsewhere on the board
/FPGA/Light_sensor_SDA: U2.111 (PIN_111); also elsewhere on the board
/FPGA/Motor_PWM_1: U2.59 (PIN_59); also elsewhere on the board
/FPGA/Motor_PWM_2: U2.60 (PIN_60); also elsewhere on the board
/FPGA/Weight_ref: U2.68 (PIN_68); also elsewhere on the board
/Reset_button: U2.33 (PIN_33); also elsewhere on the board
/Weight_sensor_N: U2.67 (PIN_67); also elsewhere on the board
/Weight_sensor_P: U2.66 (PIN_66); also elsewhere on the board
GND: C8.2, C9.2, C10.2, C11.2, C12.2, C13.2, U2.24 (CLK2), U2.25 (CLK3), U2.52 (CLK15), U2.53 (CLK14), U2.54 (CLK13), U2.55 (CLK12), U2.88 (CLK7), U2.89 (CLK6), U2.126 (CLK8), U2.127 (CLK9), U2.128 (CLK10), U2.129 (CLK11); also elsewhere on the board

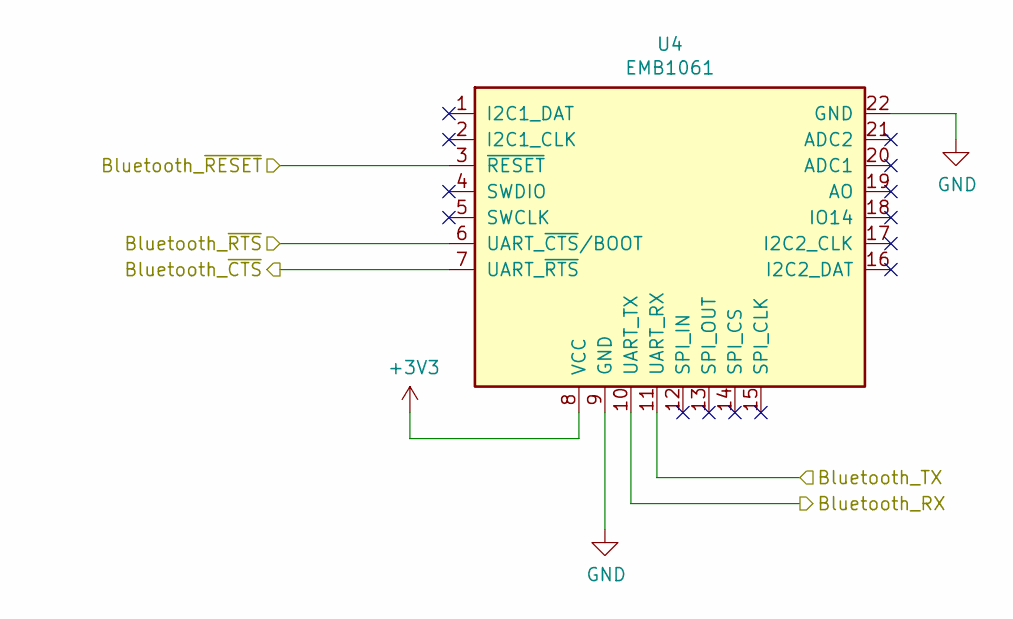
[picture p27: schematic Bluetooth.sch, Litter Robot 3 - Bluetooth module]

Parts:
U4: EMB1061; MXCHIP_EMB1061; Part_number 113990637

Connections:
+3V3: U4.8 (VCC); also elsewhere on the board
/Bluetooth/Bluetooth_RX: U4.10 (UART_TX); also elsewhere on the board
/Bluetooth/Bluetooth_TX: U4.11 (UART_RX); also elsewhere on the board
/Bluetooth/Bluetooth_~CTS: U4.7 (UART_~RTS); also elsewhere on the board
/Bluetooth/Bluetooth_~RESET: U4.3 (~RESET); also elsewhere on the board
/Bluetooth/Bluetooth_~RTS: U4.6 (UART_~CTS~/BOOT); also elsewhere on the board
GND: U4.9 (GND), U4.22 (GND); also elsewhere on the board

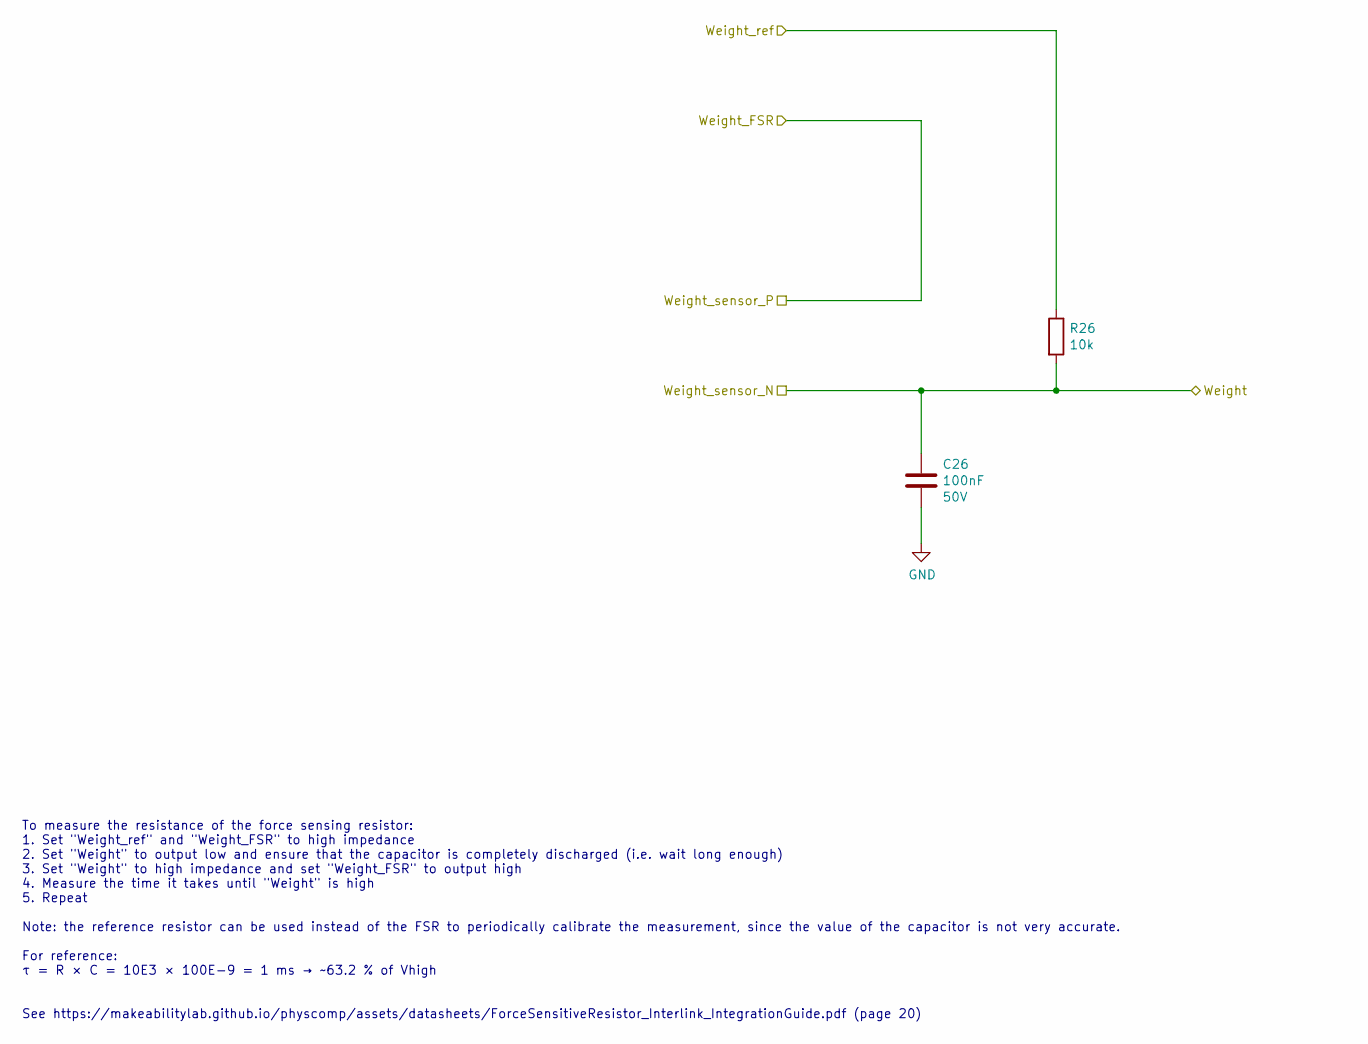
[picture p28: schematic WeightSensor.sch, Litter Robot 3 - Weight sensor]

Parts:
C26: 100nF; C_0603_1608Metric; Voltage 50V; Part_number C1608X5R1H104K080AA
R26: 10k; R_0603_1608Metric; Part_number CR0603-FX-1002ELF

Connections:
/FPGA/Weight_ref: R26.1; also elsewhere on the board
/Weight_sensor_N: C26.1, R26.2; also elsewhere on the board
GND: C26.2; also elsewhere on the board

Notes on the sheet:
To measure the resistance of the force sensing resistor: 1. Set "Weight_ref" and "Weight_FSR" to high impedance 2. Set "Weight" to output low and ensure that the capacitor is completely discharged (i.e. wait long enough) 3. Set "Weight" to high impedance and set "Weight_FSR" to output high 4. Measu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

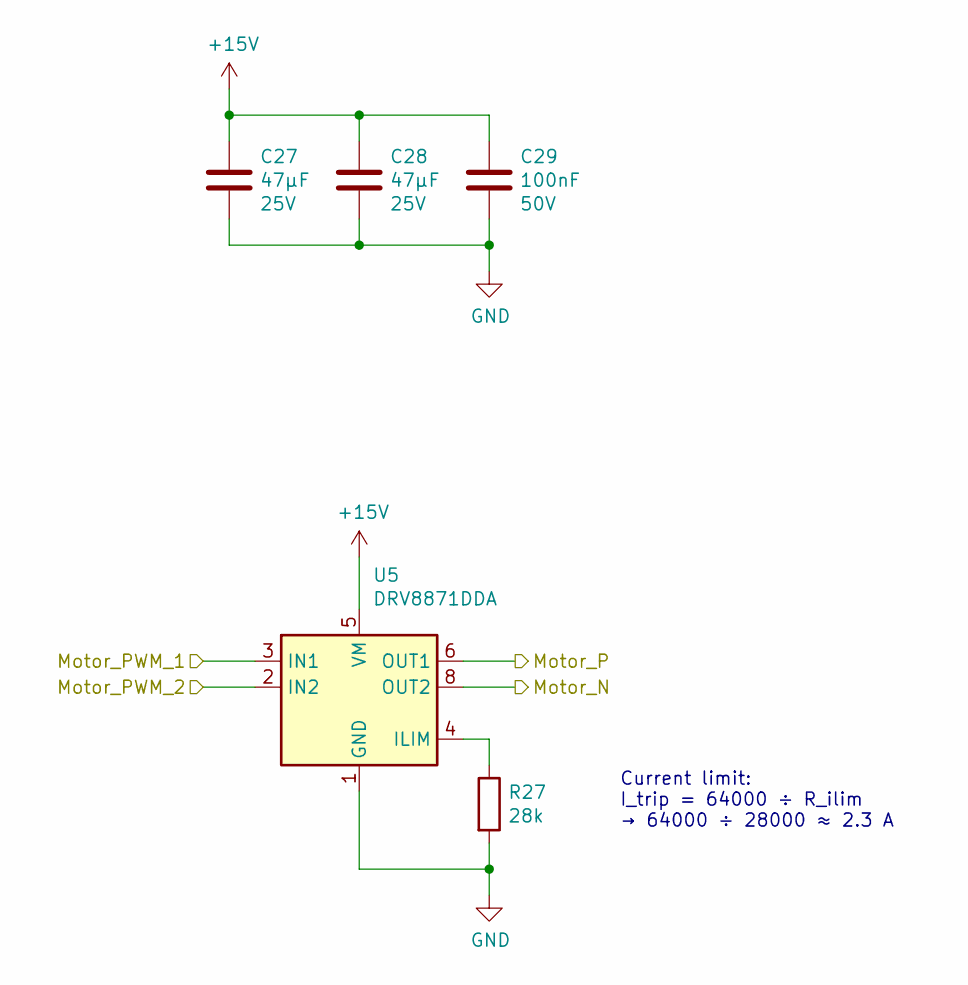
[picture p29: schematic MotorDriver.sch, Litter Robot 3 - Motor driver]

Parts:
C27, C28: 47µF; C_1206_3216Metric; Voltage 25V; Part_number C3216X5R1E476M160AC
C29: 100nF; C_0603_1608Metric; Voltage 50V; Part_number C1608X5R1H104K080AA
R27: 28k; R_0603_1608Metric; Part_number CR0603-FX-2802ELF
U5: DRV8871DDA; Texas_DRV8871; Part_number DRV8871DDARQ1

Connections:
+15V: C27.1, C28.1, C29.1, U5.5 (VM); also elsewhere on the board
/FPGA/Motor_PWM_1: U5.3 (IN1); also elsewhere on the board
/FPGA/Motor_PWM_2: U5.2 (IN2); also elsewhere on the board
/Motor_N: U5.8 (OUT2); also elsewhere on the board
/Motor_P: U5.6 (OUT1); also elsewhere on the board
GND: C27.2, C28.2, C29.2, R27.2, U5.1 (GND), U5.7 (GND), U5.9 (GND); also elsewhere on the board
unnamed: R27.1, U5.4 (ILIM)

Notes on the sheet:
Current limit: I_trip = 64000 ÷ R_ilim → 64000 ÷ 28000 ≈ 2.3 A

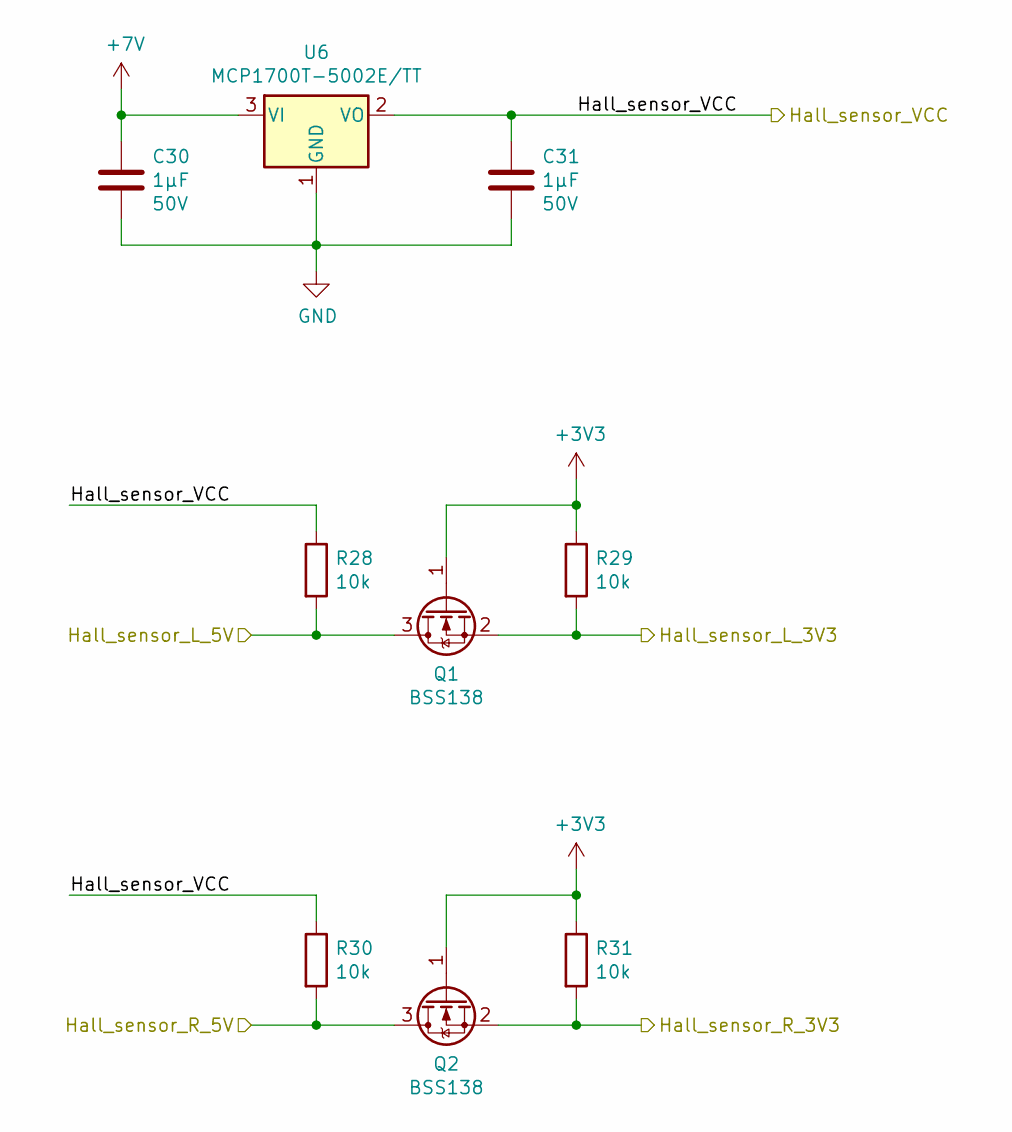
[picture p30: schematic HallSensors.sch, Litter Robot 3 - Hall sensors level shifters]

Parts:
C30, C31: 1µF; C_0603_1608Metric; Voltage 50V; Part_number C1608X5R1H105K080AB
Q1, Q2: BSS138; SOT-23; Part_number BSS138P,215
R28, R29, R30, R31: 10k; R_0603_1608Metric; Part_number CR0603-FX-1002ELF
U6: MCP1700T-5002E/TT; SOT-23; Part_number MCP1700T-5002E/TT

Connections:
+3V3: Q1.1 (G), Q2.1 (G), R29.1, R31.1; also elsewhere on the board
+7V: C30.1, U6.3 (VI); also elsewhere on the board
/FPGA/Hall_sensor_L: Q1.2 (S), R29.2; also elsewhere on the board
/FPGA/Hall_sensor_R: Q2.2 (S), R31.2; also elsewhere on the board
/Hall_sensor_L: Q1.3 (D), R28.2; also elsewhere on the board
/Hall_sensor_R: Q2.3 (D), R30.2; also elsewhere on the board
/Hall_sensor_VCC: C31.1, R28.1, R30.1, U6.2 (VO); also elsewhere on the board
GND: C30.2, C31.2, U6.1 (GND); also elsewhere on the board

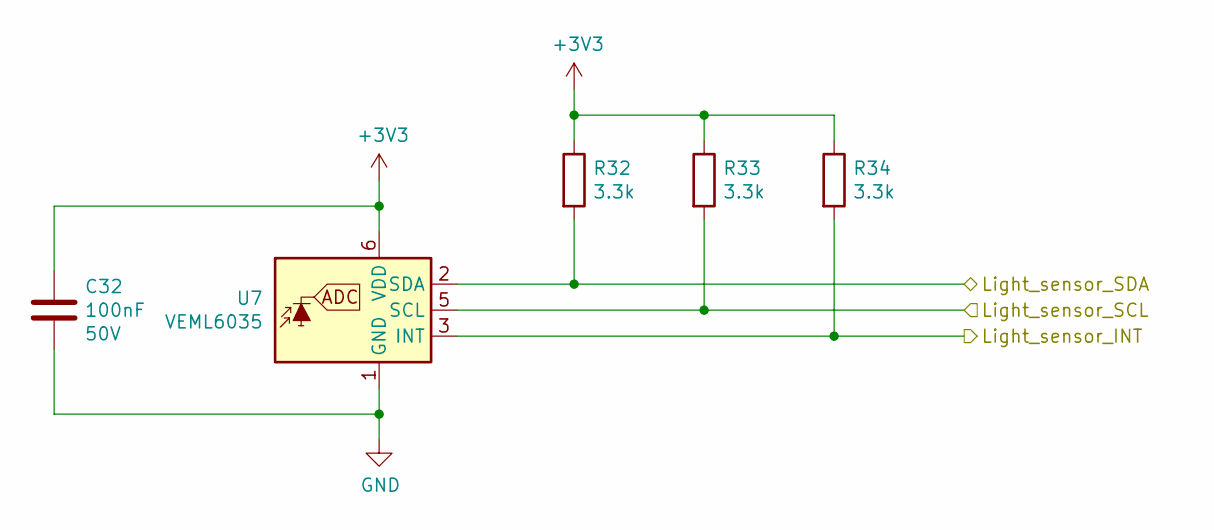
[picture p31: schematic LightSensor.sch, Litter Robot 3 - Ambient light sensor]

Parts:
C32: 100nF; C_0603_1608Metric; Voltage 50V; Part_number C1608X5R1H104K080AA
R32, R33, R34: 3.3k; R_0603_1608Metric; Part_number CR0603-FX-3301ELF
U7: VEML6035; Vishay_VEML6035; Part_number VEML6035

Connections:
+3V3: C32.1, R32.1, R33.1, R34.1, U7.6 (VDD); also elsewhere on the board
/FPGA/Light_sensor_INT: R34.2, U7.3 (INT); also elsewhere on the board
/FPGA/Light_sensor_SCL: R33.2, U7.5 (SCL); also elsewhere on the board
/FPGA/Light_sensor_SDA: R32.2, U7.2 (SDA); also elsewhere on the board
GND: C32.2, U7.1 (GND); also elsewhere on the board

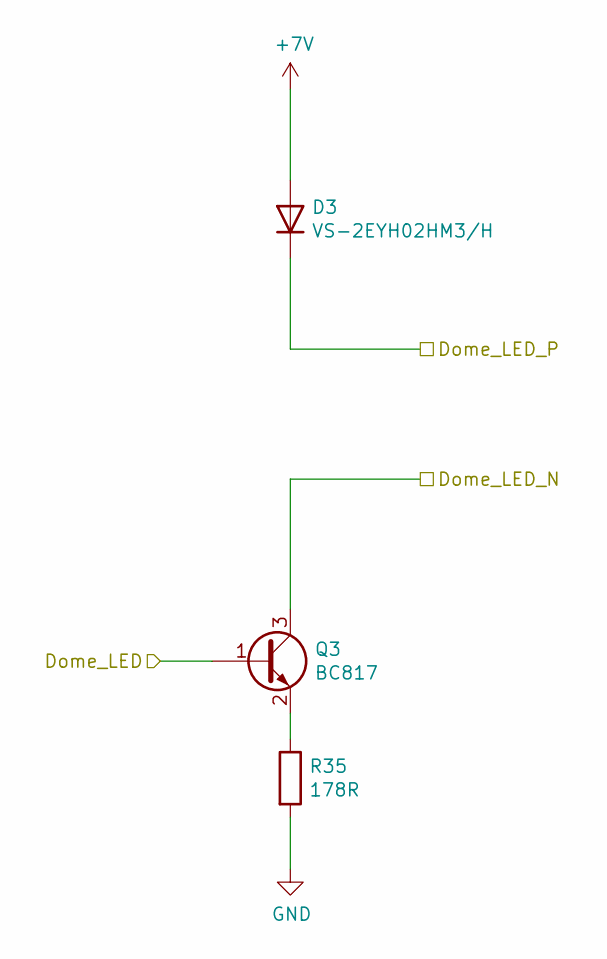
[picture p32: schematic DomeLed.sch, Litter Robot 3 - Dome LED control]

Parts:
D3: VS-2EYH02HM3/H; Vishay_SlimSMAW; Part_number VS-2EYH02HM3/H
Q3: BC817; SOT-23; Part_number BC817-25,215
R35: 178R; R_0603_1608Metric; Part_number CR0603-FX-1780ELF

Connections:
+7V: D3.2 (A); also elsewhere on the board
/Dome LED/Dome_LED: Q3.1 (B); also elsewhere on the board
/Dome_LED_N: Q3.3 (C); also elsewhere on the board
/Dome_LED_P: D3.1 (K); also elsewhere on the board
GND: R35.2; also elsewhere on the board
unnamed: Q3.2 (E), R35.1

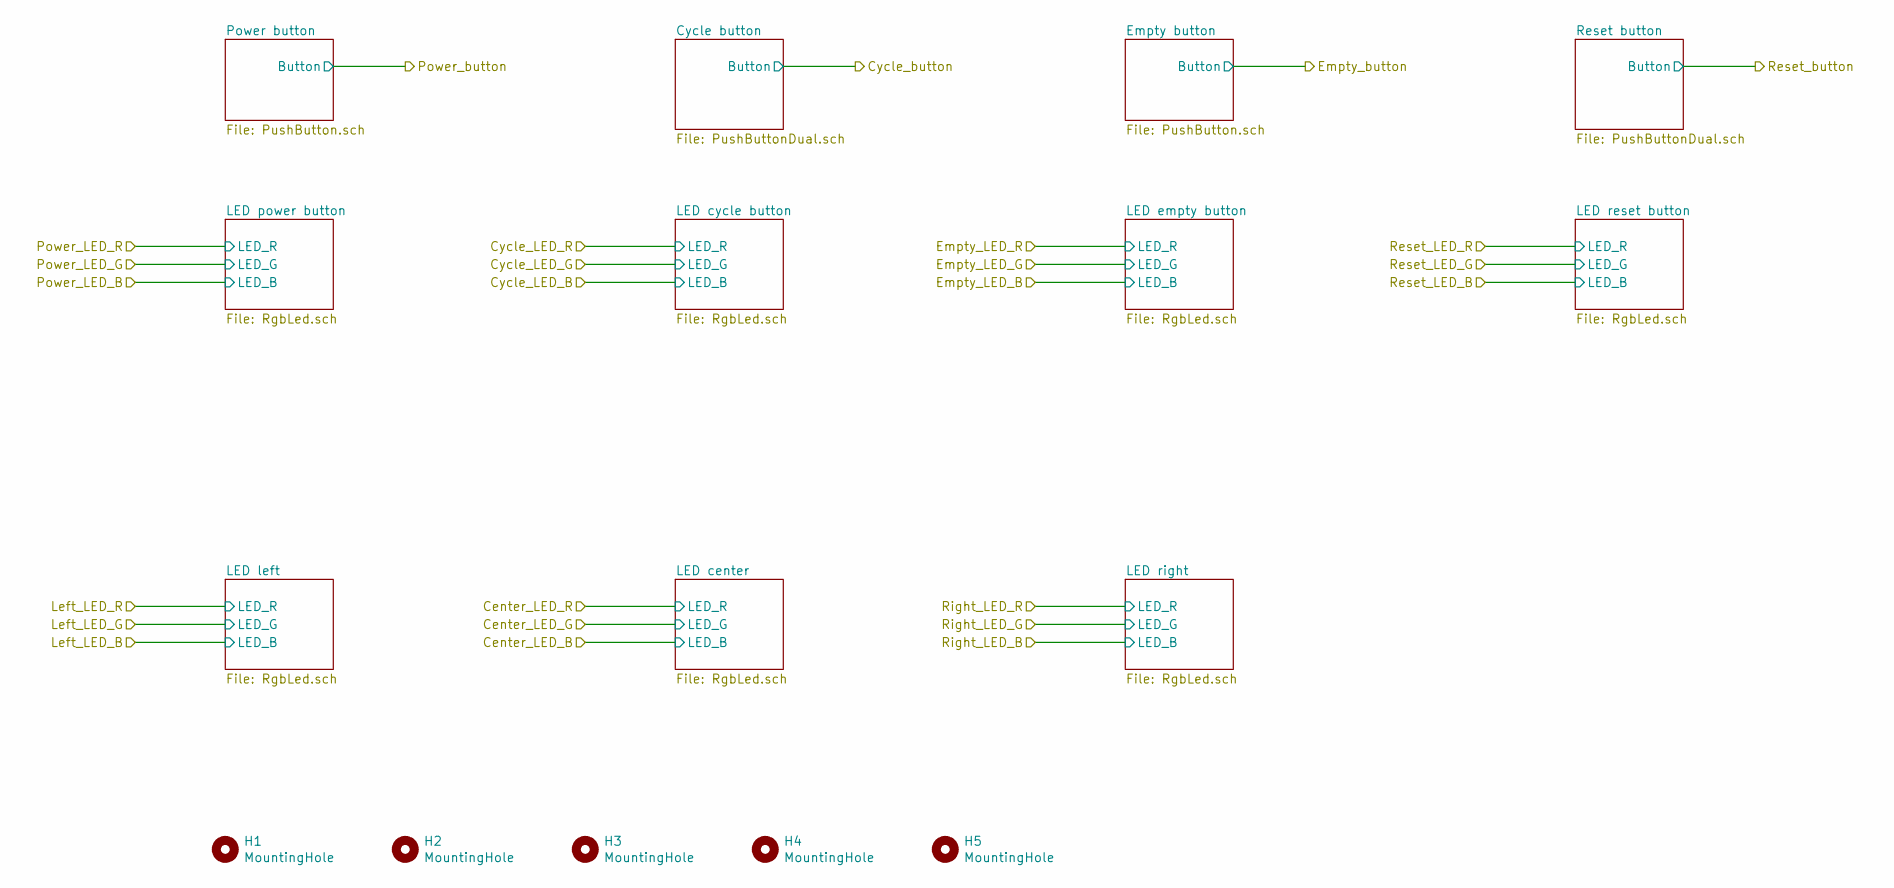
[picture p33: schematic ControlPanel.sch, Litter Robot 3 - Control panel]

Parts:
H1, H2, H3, H4, H5: MountingHole; MountingHole_4mm
