lsartory/LitterRobot/PCB/LitterRobot.kicad_pcb

## KiCad design PCB/LitterRobot.kicad_pcb (continued)

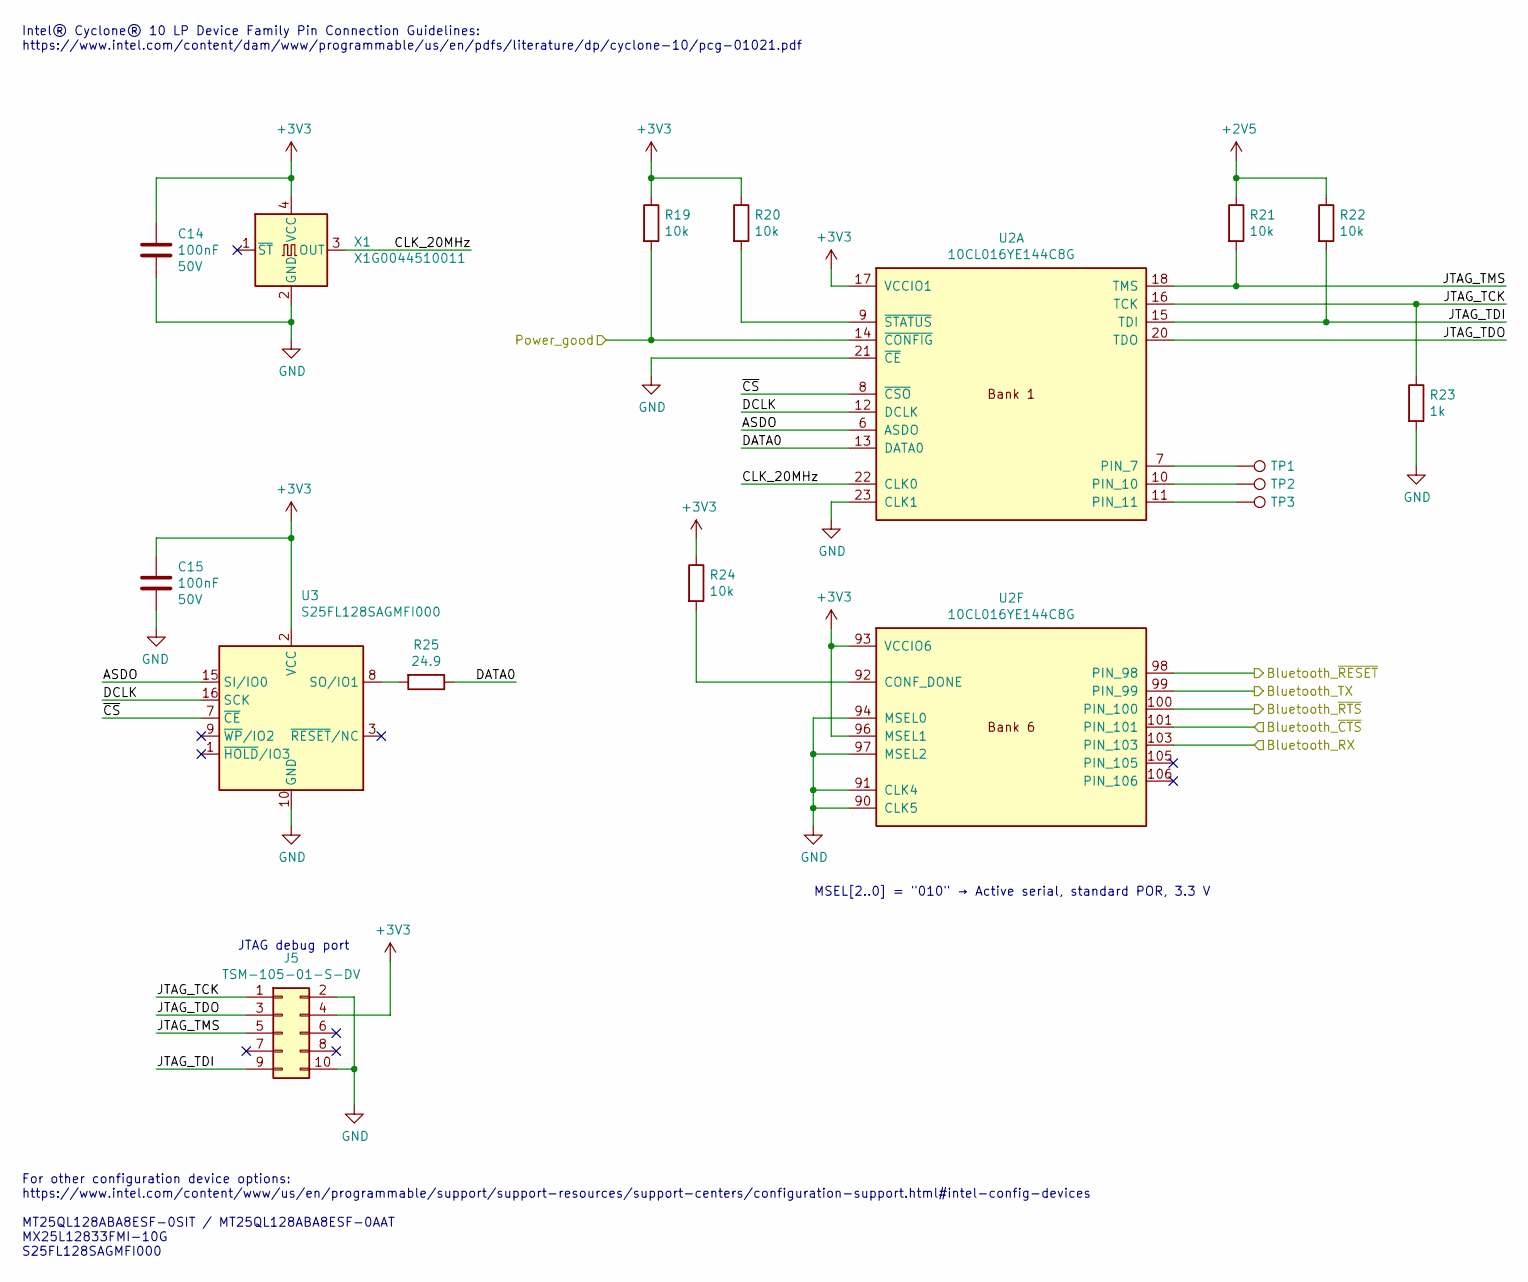
[picture p34: schematic FpgaConfig.sch, Litter Robot 3 - FPGA configuration]

Parts:
C14, C15: 100nF; C_0603_1608Metric; Voltage 50V; Part_number C1608X5R1H104K080AA
J5: TSM-105-01-S-DV; PinHeader_2x05_P2.54mm_Vertical_SMD; Part_number TSM-105-01-S-DV
R19, R20, R21, R22, R24: 10k; R_0603_1608Metric; Part_number CR0603-FX-1002ELF
R23: 1k; R_0603_1608Metric; Part_number CR0603-FX-1001ELF
R25: 24.9; R_0603_1608Metric; Part_number CR0603-FX-24R9ELF
TP1, TP2, TP3: TestPoint; TestPoint_Pad_D1.0mm
U2: 10CL016YE144C8G; Intel_EQFP-144-1EP_20x20mm_P0.5mm_EP6.7x6.7mm; Part_number 10CL016YE144C8G
U3: S25FL128SAGMFI000; SOIC-16W_7.5x10.3mm_P1.27mm; Part_number S25FL128SAGMFI000
X1: X1G0044510011; Seiko_SG5032CAN; Part_number X1G0044510011

Connections:
+2V5: R21.1, R22.1; also elsewhere on the board
+3V3: C14.1, C15.1, J5.4, R19.1, R20.1, R24.1, U2.17 (VCCIO1), U2.93 (VCCIO6), U2.96 (MSEL1), U3.2 (VCC), X1.4 (VCC); also elsewhere on the board
/Bluetooth/Bluetooth_RX: U2.103 (PIN_103); also elsewhere on the board
/Bluetooth/Bluetooth_TX: U2.99 (PIN_99); also elsewhere on the board
/Bluetooth/Bluetooth_~CTS: U2.101 (PIN_101); also elsewhere on the board
/Bluetooth/Bluetooth_~RESET: U2.98 (PIN_98); also elsewhere on the board
/Bluetooth/Bluetooth_~RTS: U2.100 (PIN_100); also elsewhere on the board
/FPGA/FPGA config/ASDO: U2.6 (ASDO), U3.15 (SI/IO0)
/FPGA/FPGA config/CLK_20MHz: U2.22 (CLK0), X1.3 (OUT)
/FPGA/FPGA config/DATA0: R25.1, U2.13 (DATA0)
/FPGA/FPGA config/DCLK: U2.12 (DCLK), U3.16 (SCK)
/FPGA/FPGA config/JTAG_TCK: J5.1, R23.1, U2.16 (TCK)
/FPGA/FPGA config/JTAG_TDI: J5.9, R22.2, U2.15 (TDI)
/FPGA/FPGA config/JTAG_TDO: J5.3, U2.20 (TDO)
/FPGA/FPGA config/JTAG_TMS: J5.5, R21.2, U2.18 (TMS)
/FPGA/FPGA config/~CS: U2.8 (~CSO), U3.7 (~CE)
/FPGA/Power_good: R19.2, U2.14 (~CONFIG); also elsewhere on the board
GND: C14.2, C15.2, J5.2, J5.10, R23.2, U2.21 (~CE), U2.23 (CLK1), U2.90 (CLK5), U2.91 (CLK4), U2.94 (MSEL0), U2.97 (MSEL2), U3.10 (GND), X1.2 (GND); also elsewhere on the board
unnamed: R20.2, U2.9 (~STATUS)
unnamed: R24.2, U2.92 (CONF_DONE)
unnamed: R25.2, U3.8 (SO/IO1)
unnamed: TP1.1, U2.7 (PIN_7)
unnamed: TP2.1, U2.10 (PIN_10)
unnamed: TP3.1, U2.11 (PIN_11)

Notes on the sheet:
JTAG debug port
MSEL[2..0] = "010" → Active serial, standard POR, 3.3 V
For other configuration device options: https://www.intel.com/content/www/us/en/programmable/support/support-resources/support-centers/configuration-support.html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 MT25QL128ABA8ESF-0SIT / MT25QL128ABA8ESF-0AAT MX25L12833FMI-10G S25FL128SAGMFI000
Intel® Cyclone® 10 LP Device Family Pin Connection Guidelines: https://www.intel.com/content/dam/www/programmable/us/en/pdfs/literature/dp/cyclone-10/pcg-01021.pdf

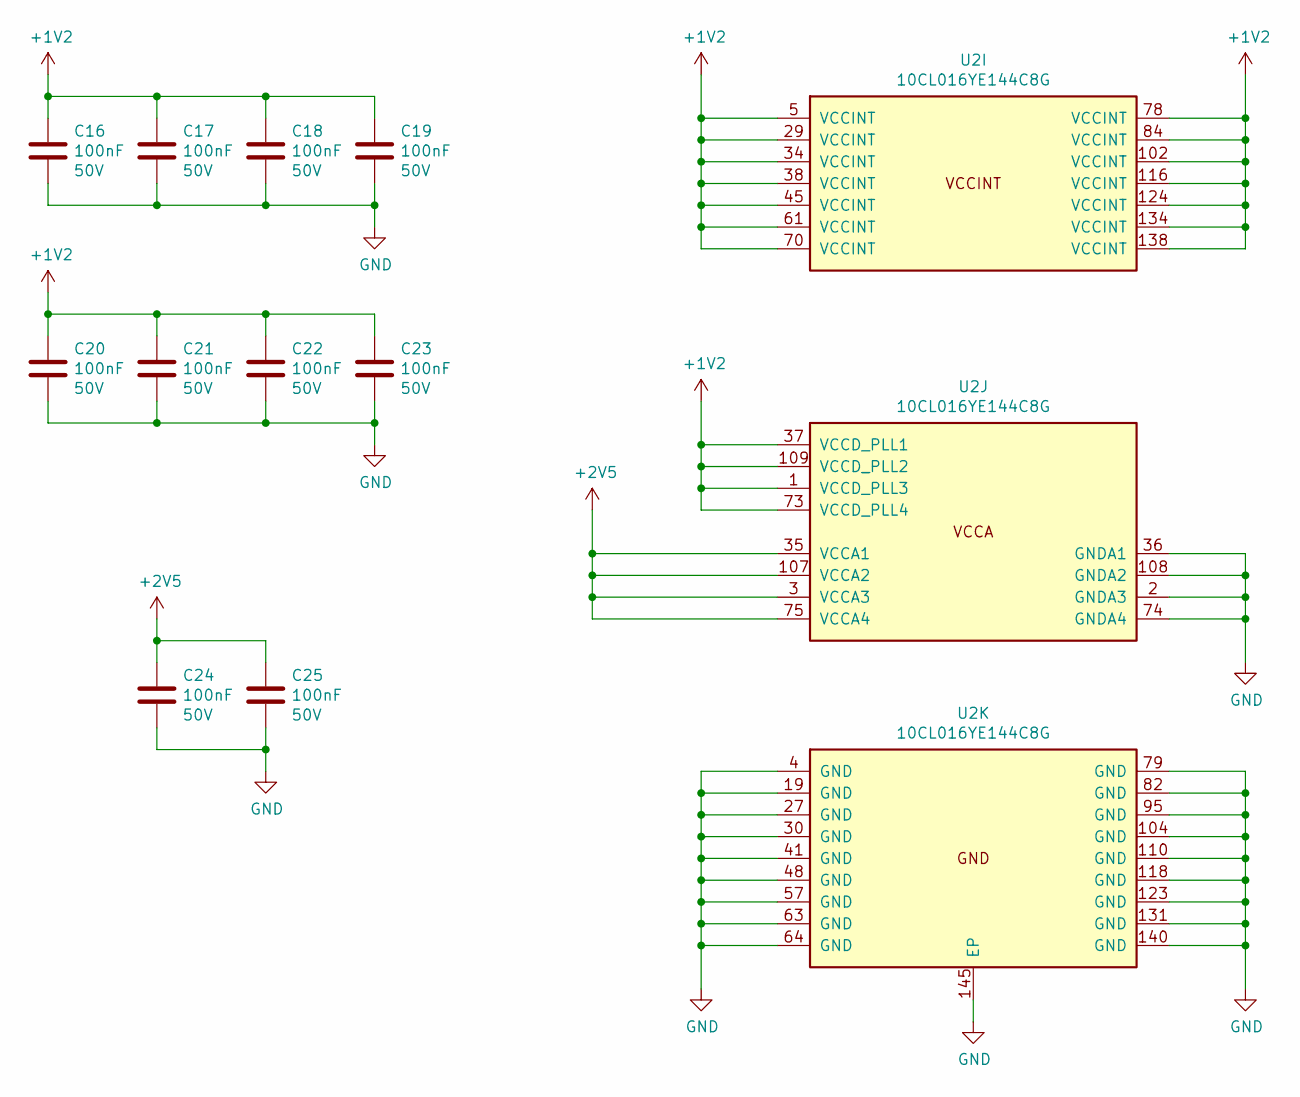
[picture p35: schematic FpgaPower.sch, Litter Robot 3 - FPGA power supply]

Parts:
C16, C17, C18, C19, C20, C21, C22, C23, C24, C25: 100nF; C_0603_1608Metric; Voltage 50V; Part_number C1608X5R1H104K080AA
U2: 10CL016YE144C8G; Intel_EQFP-144-1EP_20x20mm_P0.5mm_EP6.7x6.7mm; Part_number 10CL016YE144C8G

Connections:
+1V2: C16.1, C17.1, C18.1, C19.1, C20.1, C21.1, C22.1, C23.1, U2.1 (VCCD_PLL3), U2.5 (VCCINT), U2.29 (VCCINT), U2.34 (VCCINT), U2.37 (VCCD_PLL1), U2.38 (VCCINT), U2.45 (VCCINT), U2.61 (VCCINT), U2.70 (VCCINT), U2.73 (VCCD_PLL4), U2.78 (VCCINT), U2.84 (VCCINT), U2.102 (VCCINT), U2.109 (VCCD_PLL2), U2.116 (VCCINT), U2.124 (VCCINT), U2.134 (VCCINT), U2.138 (VCCINT); also elsewhere on the board
+2V5: C24.1, C25.1, U2.3 (VCCA3), U2.35 (VCCA1), U2.75 (VCCA4), U2.107 (VCCA2); also elsewhere on the board
GND: C16.2, C17.2, C18.2, C19.2, C20.2, C21.2, C22.2, C23.2, C24.2, C25.2, U2.2 (GNDA3), U2.4 (GND), U2.19 (GND), U2.27 (GND), U2.30 (GND), U2.36 (GNDA1), U2.41 (GND), U2.48 (GND), U2.57 (GND), U2.63 (GND), U2.64 (GND), U2.74 (GNDA4), U2.79 (GND), U2.82 (GND), U2.95 (GND), U2.104 (GND), U2.108 (GNDA2), U2.110 (GND), U2.118 (GND), U2.123 (GND), U2.131 (GND), U2.140 (GND), U2.145 (EP); also elsewhere on the board

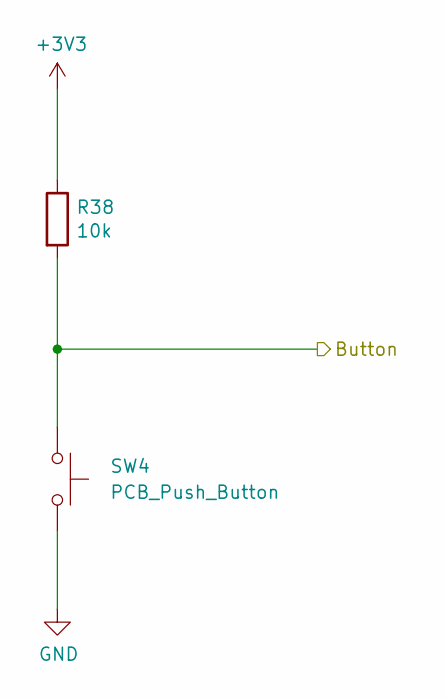
[picture p36: schematic PushButton.sch, Litter Robot 3 - Push button (single)]

Parts:
R38: 10k; R_0603_1608Metric; Part_number CR0603-FX-1002ELF
SW1: PCB_Push_Button; PCB_Push_Button_5mm_0.4mm

Connections:
+3V3: R38.1; also elsewhere on the board
GND: SW1.2; also elsewhere on the board

Parts of its further copies:
R36: 10k; R_0603_1608Metric; Part_number CR0603-FX-1002ELF
SW4: PCB_Push_Button; PCB_Push_Button_5mm_0.4mm

Connections of its further copies:
+3V3: R36.1; also elsewhere on the board
GND: SW4.2; also elsewhere on the board

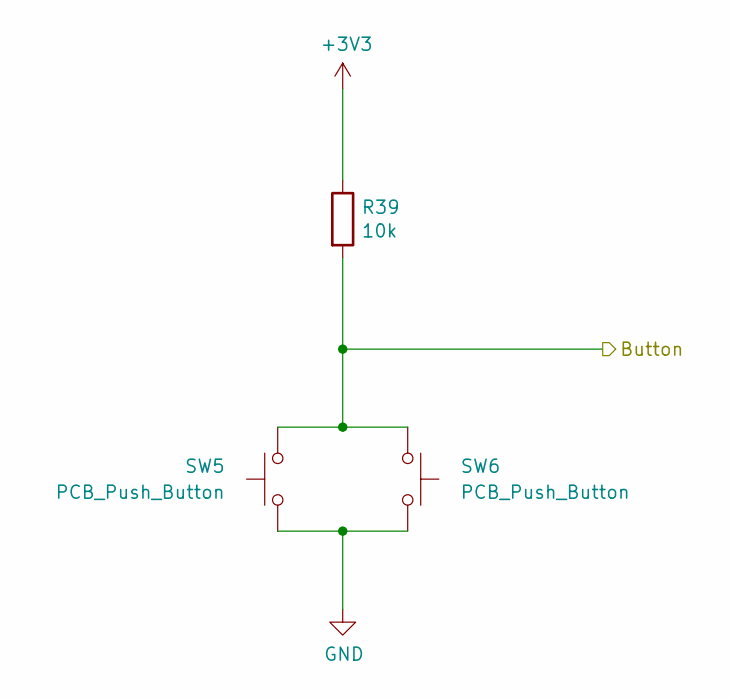
[picture p37: schematic PushButtonDual.sch, Litter Robot 3 - Push button (dual)]

Parts:
R37: 10k; R_0603_1608Metric; Part_number CR0603-FX-1002ELF
SW2, SW3: PCB_Push_Button; PCB_Push_Button_5mm_0.4mm

Connections:
+3V3: R37.1; also elsewhere on the board
/Cycle_button: R37.2, SW2.1, SW3.1; also elsewhere on the board
GND: SW2.2, SW3.2; also elsewhere on the board

Parts of its further copies:
R39: 10k; R_0603_1608Metric; Part_number CR0603-FX-1002ELF
SW5, SW6: PCB_Push_Button; PCB_Push_Button_5mm_0.4mm

Connections of its further copies:
+3V3: R39.1; also elsewhere on the board
/Reset_button: R39.2, SW5.1, SW6.1; also elsewhere on the board
GND: SW5.2, SW6.2; also elsewhere on the board

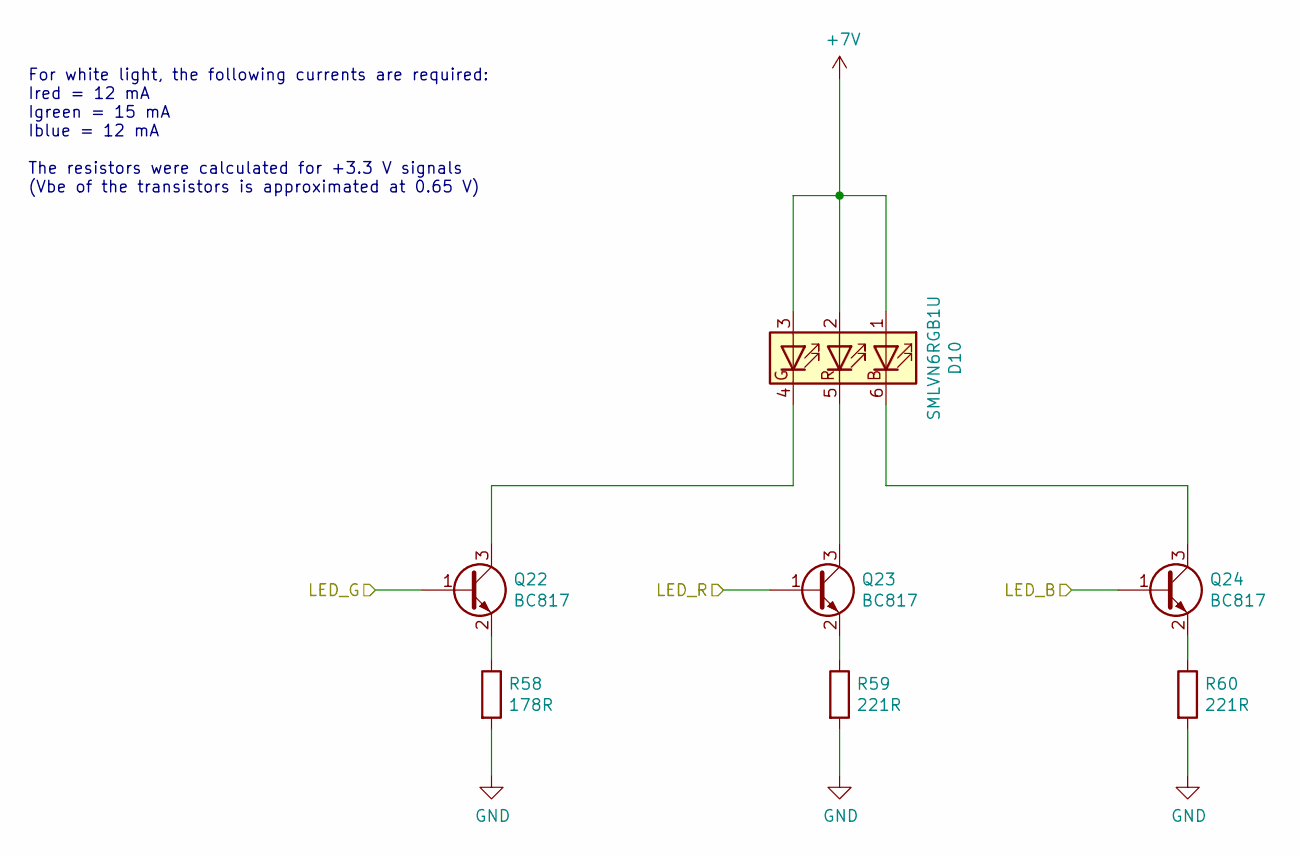
[picture p38: schematic RgbLed.sch, Litter Robot 3 - RGB LED]

Parts:
D8: SMLVN6RGB1U; ROHM_SMLVN6; Part_number SMLVN6RGB1U1
Q16, Q17, Q18: BC817; SOT-23; Part_number BC817-25,215
R52: 178R; R_0603_1608Metric; Part_number CR0603-FX-1780ELF
R53, R54: 221R; R_0603_1608Metric; Part_number CR0603-FX-2210ELF

Connections:
+7V: D8.1 (BA), D8.2 (RA), D8.3 (GA); also elsewhere on the board
/Control panel/Left_LED_B: Q18.1 (B); also elsewhere on the board
/Control panel/Left_LED_G: Q16.1 (B); also elsewhere on the board
/Control panel/Left_LED_R: Q17.1 (B); also elsewhere on the board
GND: R52.2, R53.2, R54.2; also elsewhere on the board
unnamed: D8.4 (GK), Q16.3 (C)
unnamed: D8.5 (RK), Q17.3 (C)
unnamed: D8.6 (BK), Q18.3 (C)
unnamed: Q16.2 (E), R52.1
unnamed: Q17.2 (E), R53.1
unnamed: Q18.2 (E), R54.1

Parts of its further copies:
D4, D5, D6, D7, D9, D10: SMLVN6RGB1U; ROHM_SMLVN6; Part_number SMLVN6RGB1U1
Q4, Q5, Q6, Q7, Q8, Q9, Q10, Q11, Q12, Q13, Q14, Q15, Q19, Q20, Q21, Q22, Q23, Q24: BC817; SOT-23; Part_number BC817-25,215
R40, R43, R46, R49, R55, R58: 178R; R_0603_1608Metric; Part_number CR0603-FX-1780ELF
R41, R42, R44, R45, R47, R48, R50, R51, R56, R57, R59, R60: 221R; R_0603_1608Metric; Part_number CR0603-FX-2210ELF

Connections of its further copies:
+7V: D4.1 (BA), D4.2 (RA), D4.3 (GA), D5.1 (BA), D5.2 (RA), D5.3 (GA), D6.1 (BA), D6.2 (RA), D6.3 (GA), D7.1 (BA), D7.2 (RA), D7.3 (GA), D9.1 (BA), D9.2 (RA), D9.3 (GA), D10.1 (BA), D10.2 (RA), D10.3 (GA); also elsewhere on the board
/Control panel/Center_LED_B: Q21.1 (B); also elsewhere on the board
/Control panel/Center_LED_G: Q19.1 (B); also elsewhere on the board
/Control panel/Center_LED_R: Q20.1 (B); also elsewhere on the board
/Control panel/Cycle_LED_B: Q9.1 (B); also elsewhere on the board
/Control panel/Cycle_LED_G: Q7.1 (B); also elsewhere on the board
/Control panel/Cycle_LED_R: Q8.1 (B); also elsewhere on the board
/Control panel/Empty_LED_B: Q12.1 (B); also elsewhere on the board
/Control panel/Empty_LED_G: Q10.1 (B); also elsewhere on the board
/Control panel/Empty_LED_R: Q11.1 (B); also elsewhere on the board
/Control panel/Power_LED_B: Q6.1 (B); also elsewhere on the board
/Control panel/Power_LED_G: Q4.1 (B); also elsewhere on the board
/Control panel/Power_LED_R: Q5.1 (B); also elsewhere on the board
/Control panel/Reset_LED_B: Q15.1 (B); also elsewhere on the board
/Control panel/Reset_LED_G: Q13.1 (B); also elsewhere on the board
/Control panel/Reset_LED_R: Q14.1 (B); also elsewhere on the board
/Control panel/Right_LED_B: Q24.1 (B); also elsewhere on the board
/Control panel/Right_LED_G: Q22.1 (B); also elsewhere on the board
/Control panel/Right_LED_R: Q23.1 (B); also elsewhere on the board
GND: R40.2, R41.2, R42.2, R43.2, R44.2, R45.2, R46.2, R47.2, R48.2, R49.2, R50.2, R51.2, R55.2, R56.2, R57.2, R58.2, R59.2, R60.2; also elsewhere on the board
unnamed: D4.4 (GK), Q4.3 (C)
unnamed: D4.5 (RK), Q5.3 (C)
unnamed: D4.6 (BK), Q6.3 (C)
unnamed: D5.4 (GK), Q7.3 (C)
unnamed: D5.5 (RK), Q8.3 (C)
unnamed: D5.6 (BK), Q9.3 (C)
unnamed: D6.4 (GK), Q10.3 (C)
unnamed: D6.5 (RK), Q11.3 (C)
unnamed: D6.6 (BK), Q12.3 (C)
unnamed: D7.4 (GK), Q13.3 (C)
unnamed: D7.5 (RK), Q14.3 (C)
unnamed: D7.6 (BK), Q15.3 (C)
unnamed: D9.4 (GK), Q19.3 (C)
unnamed: D9.5 (RK), Q20.3 (C)
unnamed: D9.6 (BK), Q21.3 (C)
unnamed: D10.4 (GK), Q22.3 (C)
unnamed: D10.5 (RK), Q23.3 (C)
unnamed: D10.6 (BK), Q24.3 (C)
unnamed: Q4.2 (E), R40.1
unnamed: Q5.2 (E), R41.1
unnamed: Q6.2 (E), R42.1
unnamed: Q7.2 (E), R43.1
unnamed: Q8.2 (E), R44.1
unnamed: Q9.2 (E), R45.1
unnamed: Q10.2 (E), R46.1
unnamed: Q11.2 (E), R47.1
unnamed: Q12.2 (E), R48.1
unnamed: Q13.2 (E), R49.1
unnamed: Q14.2 (E), R50.1
unnamed: Q15.2 (E), R51.1
unnamed: Q19.2 (E), R55.1
unnamed: Q20.2 (E), R56.1
unnamed: Q21.2 (E), R57.1
unnamed: Q22.2 (E), R58.1
unnamed: Q23.2 (E), R59.1
unnamed: Q24.2 (E), R60.1

Notes on the sheet:
For white light, the following currents are required: Ired = 12 mA Igreen = 15 mA Iblue = 12 mA The resistors were calculated for +3.3 V signals (Vbe of the transistors is approximated at 0.65 V)

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
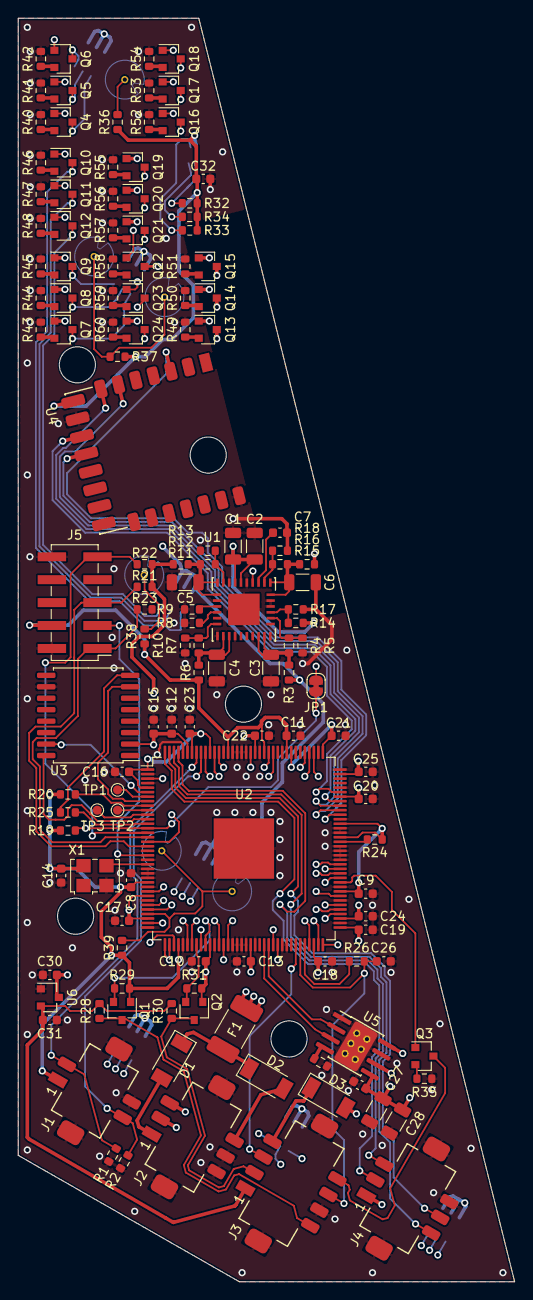
[picture p39: board LitterRobot.kicad_pcb from above]

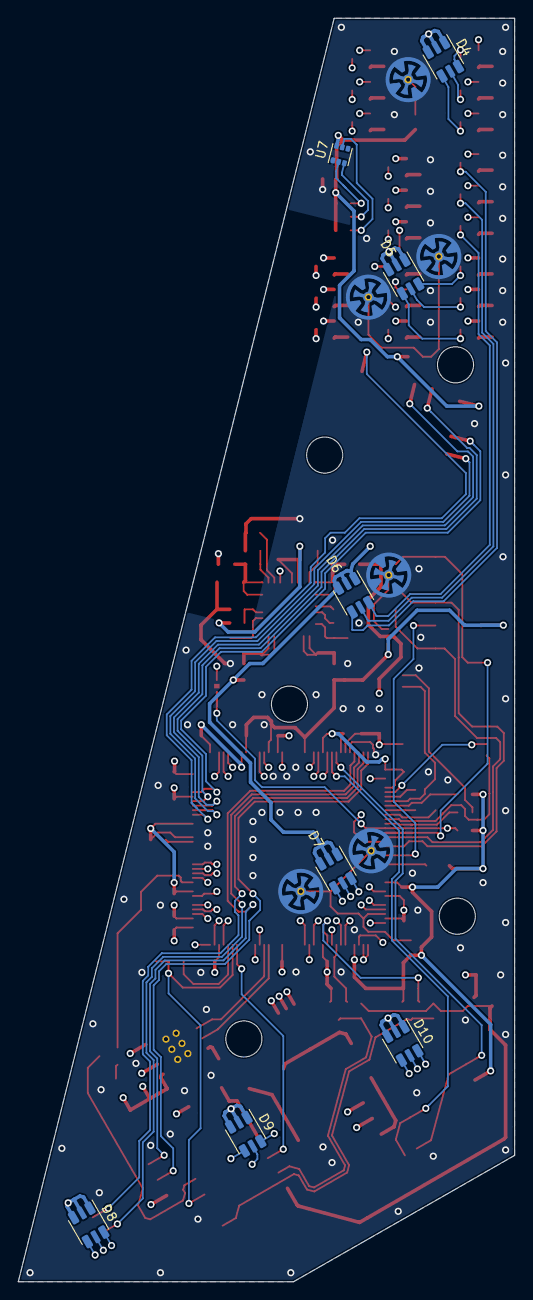
[picture p40: board LitterRobot.kicad_pcb from below]

Board: 4 copper layers, 55.0 x 140.0 mm, 155 parts (19 on the bottom side), 136 nets.
