lsartory/LitterRobot/FPGA/LitterRobot.qsf

set_global_assignment -name TOP_LEVEL_ENTITY LitterRobot
set_global_assignment -name ORIGINAL_QUARTUS_VERSION 20.1.1
set_global_assignment -name PROJECT_CREATION_TIME_DATE "17:55:34  MARCH 27, 2021"
set_global_assignment -name LAST_QUARTUS_VERSION "20.1.1 Lite Edition"
set_global_assignment -name PROJECT_OUTPUT_DIRECTORY output_files
set_global_assignment -name PROJECT_IP_REGENERATION_POLICY ALWAYS_REGENERATE_IP
set_global_assignment -name SAVE_DISK_SPACE OFF
set_global_assignment -name SMART_RECOMPILE ON
set_global_assignment -name TIMING_ANALYZER_MULTICORNER_ANALYSIS ON
set_global_assignment -name FLOW_ENABLE_IO_ASSIGNMENT_ANALYSIS ON
set_global_assignment -name NUM_PARALLEL_PROCESSORS 4

set_global_assignment -name FAMILY "Cyclone 10 LP"
set_global_assignment -name DEVICE 10CL016YE144C8G
set_global_assignment -name DEVICE_MIGRATION_LIST "10CL016YE144C8G,10CL006YE144C8G,10CL010YE144C8G,10CL025YE144C8G"

set_global_assignment -name USE_CONFIGURATION_DEVICE ON
set_global_assignment -name CYCLONEIII_CONFIGURATION_DEVICE S25FL128
set_global_assignment -name CONFIGURATION_VCCIO_LEVEL 3.3V
set_global_assignment -name GENERATE_RBF_FILE ON

set_global_assignment -name NOMINAL_CORE_SUPPLY_VOLTAGE 1.2V
set_global_assignment -name STRATIX_DEVICE_IO_STANDARD "3.3-V LVTTL"
set_global_assignment -name MIN_CORE_JUNCTION_TEMP 0
set_global_assignment -name MAX_CORE_JUNCTION_TEMP 85
set_global_assignment -name POWER_USE_DEVICE_CHARACTERISTICS MAXIMUM
set_global_assignment -name POWER_PRESET_COOLING_SOLUTION "NO HEAT SINK WITH STILL AIR"
set_global_assignment -name POWER_BOARD_THERMAL_MODEL "NONE (CONSERVATIVE)"

set_global_assignment -name RESERVE_ALL_UNUSED_PINS_WEAK_PULLUP "AS INPUT TRI-STATED"
set_global_assignment -name ENABLE_BOOT_SEL_PIN OFF
set_global_assignment -name ENABLE_CONFIGURATION_PINS OFF
set_global_assignment -name ENABLE_OCT_DONE OFF

set_global_assignment -name OUTPUT_IO_TIMING_NEAR_END_VMEAS "HALF VCCIO" -rise
set_global_assignment -name OUTPUT_IO_TIMING_NEAR_END_VMEAS "HALF VCCIO" -fall
set_global_assignment -name OUTPUT_IO_TIMING_FAR_END_VMEAS "HALF SIGNAL SWING" -rise
set_global_assignment -name OUTPUT_IO_TIMING_FAR_END_VMEAS "HALF SIGNAL SWING" -fall

set_global_assignment -name CYCLONEII_RESERVE_NCEO_AFTER_CONFIGURATION "USE AS REGULAR IO"
set_global_assignment -name CRC_ERROR_CHECKING OFF
set_global_assignment -name CRC_ERROR_OPEN_DRAIN OFF

set_location_assignment PIN_22 -to CLK_20MHz
set_location_assignment PIN_98 -to BLUETOOTH_RESETn
set_location_assignment PIN_99 -to BLUETOOTH_TX
set_location_assignment PIN_103 -to BLUETOOTH_RX
set_location_assignment PIN_100 -to BLUETOOTH_RTSn
set_location_assignment PIN_101 -to BLUETOOTH_CTSn
set_location_assignment PIN_67 -to WEIGHT
set_location_assignment PIN_68 -to WEIGHT_REF
set_location_assignment PIN_66 -to WEIGHT_FSR
set_location_assignment PIN_59 -to MOTOR_PWM[1]
set_location_assignment PIN_60 -to MOTOR_PWM[2]
set_location_assignment PIN_46 -to HALL_SENSOR_L
set_location_assignment PIN_44 -to HALL_SENSOR_R
set_location_assignment PIN_136 -to DFI[1]
set_location_assignment PIN_137 -to DFI[2]
set_location_assignment PIN_111 -to LIGHT_SENSOR_SDA
set_location_assignment PIN_113 -to LIGHT_SENSOR_SCL
set_location_assignment PIN_112 -to LIGHT_SENSOR_INT
set_location_assignment PIN_83 -to DOME_LED
set_location_assignment PIN_28 -to POWER_BUTTON
set_location_assignment PIN_31 -to CYCLE_BUTTON
set_location_assignment PIN_32 -to EMPTY_BUTTON
set_location_assignment PIN_33 -to RESET_BUTTON
set_location_assignment PIN_76 -to POWER_LED_R
set_location_assignment PIN_72 -to POWER_LED_G
set_location_assignment PIN_71 -to POWER_LED_B
set_location_assignment PIN_39 -to CYCLE_LED_R
set_location_assignment PIN_43 -to CYCLE_LED_G
set_location_assignment PIN_42 -to CYCLE_LED_B
set_location_assignment PIN_50 -to EMPTY_LED_R
set_location_assignment PIN_51 -to EMPTY_LED_G
set_location_assignment PIN_49 -to EMPTY_LED_B
set_location_assignment PIN_121 -to RESET_LED_R
set_location_assignment PIN_120 -to RESET_LED_G
set_location_assignment PIN_125 -to RESET_LED_B
set_location_assignment PIN_133 -to LEFT_LED_R
set_location_assignment PIN_132 -to LEFT_LED_G
set_location_assignment PIN_135 -to LEFT_LED_B
set_location_assignment PIN_87 -to CENTER_LED_R
set_location_assignment PIN_86 -to CENTER_LED_G
set_location_assignment PIN_85 -to CENTER_LED_B
set_location_assignment PIN_77 -to RIGHT_LED_R
set_location_assignment PIN_69 -to RIGHT_LED_G
set_location_assignment PIN_80 -to RIGHT_LED_B

set_instance_assignment -name CURRENT_STRENGTH_NEW "MAXIMUM CURRENT" -to *_LED_*
set_instance_assignment -name CURRENT_STRENGTH_NEW "MAXIMUM CURRENT" -to BLUETOOTH_*
set_instance_assignment -name CURRENT_STRENGTH_NEW "MAXIMUM CURRENT" -to DFI*
set_instance_assignment -name CURRENT_STRENGTH_NEW "MAXIMUM CURRENT" -to DOME_LED
set_instance_assignment -name CURRENT_STRENGTH_NEW "MAXIMUM CURRENT" -to LIGHT_SENSOR_*
set_instance_assignment -name CURRENT_STRENGTH_NEW "MAXIMUM CURRENT" -to MOTOR_PWM*
set_instance_assignment -name CURRENT_STRENGTH_NEW "MAXIMUM CURRENT" -to WEIGHT*

set_global_assignment -name SDC_FILE LitterRobot.sdc
set_global_assignment -name VHDL_FILE AmbientLightSensor.vhd
set_global_assignment -name VHDL_FILE ClockScaler.vhd
set_global_assignment -name VHDL_FILE CycleProcess.vhd
set_global_assignment -name VHDL_FILE I2cController.vhd
set_global_assignment -name VHDL_FILE LedController.vhd
set_global_assignment -name VHDL_FILE LedModulator.vhd
set_global_assignment -name VHDL_FILE LitterRobot.vhd
set_global_assignment -name VHDL_FILE PinchSensor.vhd
set_global_assignment -name VHDL_FILE PulseDensityModulator.vhd
set_global_assignment -name VHDL_FILE WeightSensor.vhd

set_global_assignment -name PARTITION_NETLIST_TYPE SOURCE -section_id Top
set_global_assignment -name PARTITION_FITTER_PRESERVATION_LEVEL PLACEMENT_AND_ROUTING -section_id Top
set_global_assignment -name PARTITION_COLOR 16764057 -section_id Top
set_instance_assignment -name PARTITION_HIERARCHY root_partition -to | -section_id Top
