lsartory/LitterRobot/(commit log)

2021-02-28 Add more Hirose connectors 3D models
    [DF11C-4DP-2V.stp, DF11C-6DP-2V.stp, DF11C-8DP-2V.stp]
2021-02-28 Added Hirose footprints
    [LitterRobot.kicad_pcb, LitterRobot.sch]
2021-02-28 Add RGB LEDs to the schematic
    [ControlPanel.sch, LitterRobot.kicad_pcb, LitterRobot.sch, PushButton.sch, RgbLed.sch]
2021-03-02 Add an extension connector
    [LitterRobot.sch]
2021-03-02 Add placeholder sheets for functions to be implemented
    [ControlPanel.sch, FPGA.sch, LitterRobot.sch, MotorDriver.sch, PowerSupply.sch, RgbLed.sch]
2021-03-07 Add the power supply and motor driver ICs
    [LitterRobot.sch, MotorDriver.sch, PowerSupply.sch, RgbLed.sch]
2021-03-07 Add the MPM54304 footprint
    [PowerSupply.sch, RgbLed.sch]
2021-03-07 Add the board outline
    [LitterRobot.kicad_pcb]
2021-03-13 Add the push buttons and mounting holes
    [ControlPanel.sch, LitterRobot.sch, MotorDriver.sch, PowerSupply.sch, PushButton.sch, PushButtonDual.sch, RgbLed.sch]
2021-03-14 Place the main components on the PCB
    [LitterRobot.kicad_pcb, LitterRobot.sch, PushButton.sch, PushButtonDual.sch, RgbLed.sch]
2021-03-16 Add TODO notes
    [FPGA.sch, PowerSupply.sch]
2021-03-20 Add a footprint for Bel Fuse 0ZCG PTCs
2021-03-20 Add fuse and more inter-page signals
    [ControlPanel.sch, FPGA.sch, LitterRobot.sch, MotorDriver.sch, PowerSupply.sch, PushButton.sch, PushButtonDual.sch, RgbLed.sch]
2021-03-20 Add an ambient light sensor
    [ControlPanel.sch, FPGA.sch, LitterRobot.kicad_pcb, LitterRobot.sch, MotorDriver.sch, PowerSupply.sch, PushButton.sch, PushButtonDual.sch]
2021-03-20 Add the missing light sensor files
    [LightSensor.sch]
2021-03-20 Add the FPGA footprint
    [LitterRobot.kicad_pcb]
2021-03-27 Add support components for the FPGA
    - Configuration EEPROM
    - 20 MHz oscillator
    - JTAG debug port connector
    [FPGA.sch, LightSensor.sch, LitterRobot.kicad_pcb, PowerSupply.sch]
2021-03-27 Update the TODO lists
    [FPGA.sch, LitterRobot.sch]
2021-03-27 Initial commit of the Quartus project
    [ControlPanel.sch, FPGA.sch, LightSensor.sch, LitterRobot.kicad_pcb, LitterRobot.sch, MotorDriver.sch, PowerSupply.sch, PushButton.sch]
2021-03-28 Add the FPGA symbol
    [ControlPanel.sch, FPGA.sch, Fpga.sch, FpgaConfig.sch, FpgaPower.sch, LightSensor.sch, LitterRobot.kicad_pcb, LitterRobot.sch]
2021-03-28 Connect the FPGA configuration signals
    [Fpga.sch, FpgaConfig.sch, FpgaPower.sch, LightSensor.sch, LitterRobot.kicad_pcb, LitterRobot.sch, MotorDriver.sch, PowerSupply.sch]
2021-03-28 Add missing capacitor datasheets
    [FpgaConfig.sch, FpgaPower.sch, LightSensor.sch, LitterRobot.sch, MotorDriver.sch, PowerSupply.sch, PushButton.sch, PushButtonDual.sch]
2021-03-28 Cleaned up the schematics
    [Fpga.sch, FpgaConfig.sch, FpgaPower.sch, LitterRobot.kicad_pcb, LitterRobot.sch, PowerSupply.sch, RgbLed.sch]
2021-03-28 Plot the schematic as PDF
    [ControlPanel.sch, Fpga.sch, FpgaPower.sch, LightSensor.sch, LitterRobot.kicad_pcb, LitterRobot.sch, MotorDriver.sch, PowerSupply.sch]
2021-04-02 Improve the push buttons
    [LitterRobot.kicad_pcb, PushButton.sch, PushButtonDual.sch, RgbLed.sch]
2021-04-02 Add reverse polarity protection diodes
    [LitterRobot.sch, PowerSupply.sch, PushButtonDual.sch, RgbLed.sch]
2021-04-02 Add support for the weight sensor
    [ControlPanel.sch, Fpga.sch, FpgaConfig.sch, FpgaPower.sch, LightSensor.sch, LitterRobot.kicad_pcb, LitterRobot.sch, MotorDriver.sch]
2021-04-03 Add support for the hall sensors and dome LED
    [ControlPanel.sch, DomeLed.sch, Fpga.sch, FpgaConfig.sch, FpgaPower.sch, HallSensors.sch, LightSensor.sch, LitterRobot.kicad_pcb]
2021-04-05 Reduce the weight sensor capacitor value
    [WeightSensor.sch]
2021-04-05 Fix the oscillator footprint
    [FpgaConfig.sch]
2021-04-05 Re-annotate all components
    [ControlPanel.sch, DomeLed.sch, Fpga.sch, FpgaPower.sch, HallSensors.sch, LightSensor.sch, LitterRobot.sch, MotorDriver.sch]
2021-04-05 Add vias to the PCB push button footprints
2021-04-05 Add a 3D model for the oscillator
    [FpgaConfig.sch, PushButtonDual.sch, RgbLed.sch]
2021-04-05 Change the higher value capacitors to 1206
    [MotorDriver.sch, PowerSupply.sch]
2021-04-05 Add a 3D model for the SlimSMAW diodes
    [DomeLed.sch, PowerSupply.sch]
2021-04-05 Place all the components on the board
    [LitterRobot.kicad_pcb]
2021-04-05 Update the schematics PDF
2021-04-05 Adapt the DRV8871 footprint for the PCB constraints
    [LitterRobot.kicad_pcb, MotorDriver.sch]
2021-04-05 Fix the VEML6035 pad clearance
    [LitterRobot.kicad_pcb]
2021-04-10 Add the EMB1061 Bluetooth module
    [Bluetooth.sch, ControlPanel.sch, DomeLed.sch, Fpga.sch, FpgaConfig.sch, FpgaPower.sch, HallSensors.sch, LightSensor.sch]
2021-04-10 Connect the Bluetooth module to the FPGA
    [Bluetooth.sch, ControlPanel.sch, DomeLed.sch, Fpga.sch, FpgaConfig.sch, HallSensors.sch, LightSensor.sch, LitterRobot.sch]
2021-04-11 Place the Bluetooth module on the PCB
    [LitterRobot.kicad_pcb]
2021-04-11 Start routing the PCB
    [LitterRobot.kicad_pcb]
2021-04-11 Improve the PCB push button footprints
    [LitterRobot.kicad_pcb]
2021-05-02 Route more signals
    [Fpga.sch, FpgaConfig.sch, LitterRobot.kicad_pcb, PushButtonDual.sch, RgbLed.sch]
2021-05-17 Fix invalid / missing part numbers
    [Bluetooth.sch, RgbLed.sch]
2021-05-24 Complete routing all signals
    [Fpga.sch, LitterRobot.kicad_pcb, LitterRobot.sch, RgbLed.sch]
2021-05-24 Export BOM
    [DomeLed.sch, LitterRobot.kicad_pcb, LitterRobot_BOM.csv, RgbLed.sch]
2021-05-24 Add jumpers on the power supply outputs
    [Bluetooth.sch, ControlPanel.sch, DomeLed.sch, Fpga.sch, FpgaConfig.sch, FpgaPower.sch, HallSensors.sch, LightSensor.sch]
2021-05-29 Increase via drill size to 0.45 mm
    [LitterRobot.kicad_pcb]
2021-06-23 Add FPGA pin assignments and a simple modulator for the LEDs
2021-06-23 Fix the positions of R4 and R5 in the silkscreen layer
    [LitterRobot.kicad_pcb]
2021-06-27 Add a LED controller and temporary test implementation
2021-07-05 Animate the LEDs and make them brighter when buttons are pressed
2021-07-05 Add basic resistance measurement
2021-07-17 Implement the light sensor interface
2021-07-31 Dim the LEDs depending on the ambient brightness
2021-08-21 Improve the LED brightness control
